ryood/I2S_FG/P1100434.jpg

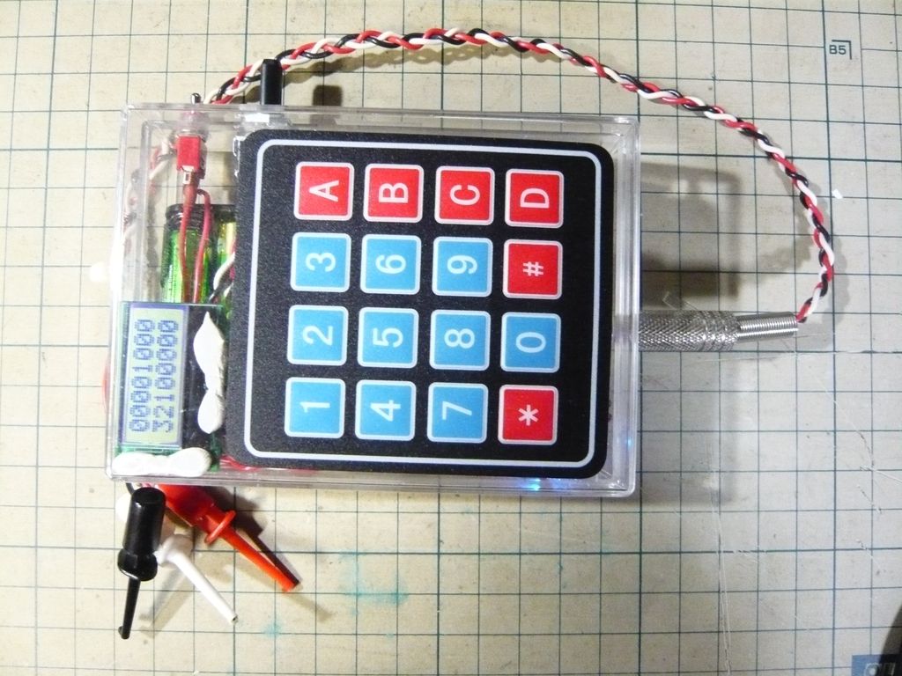
P1100434.jpg
