ryood/I2S_FG/P1100431.jpg

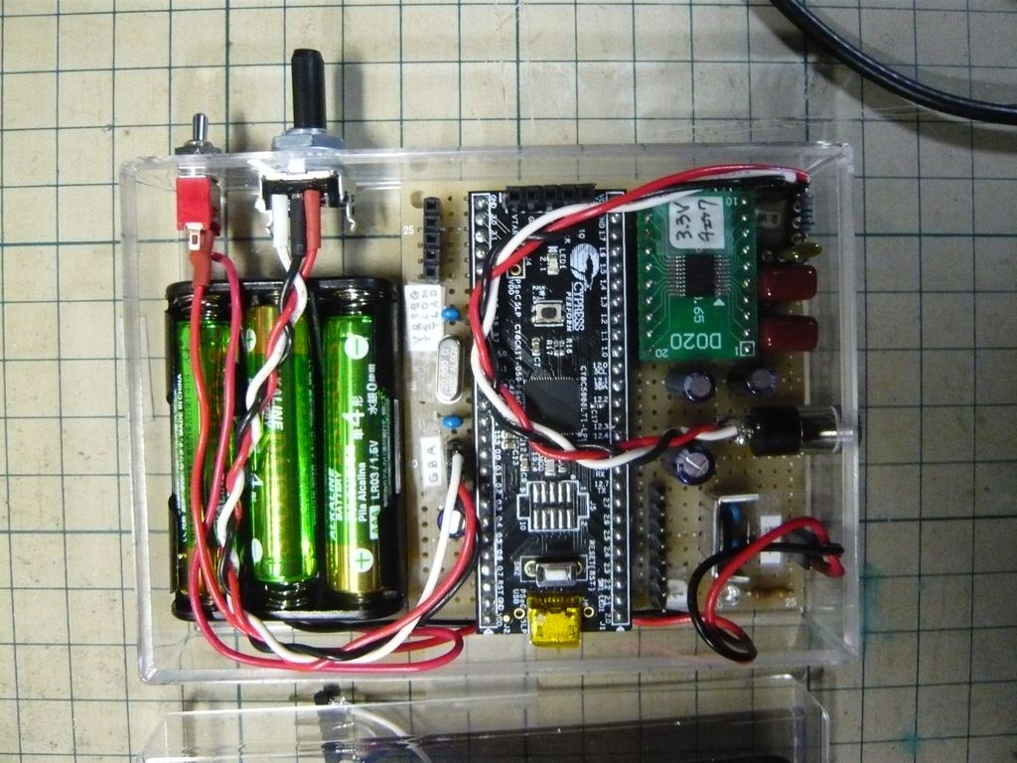
P1100431.jpg
