ryood/I2S_FG/Fritzing/I2S_FG_UI_ブレッドボード.png

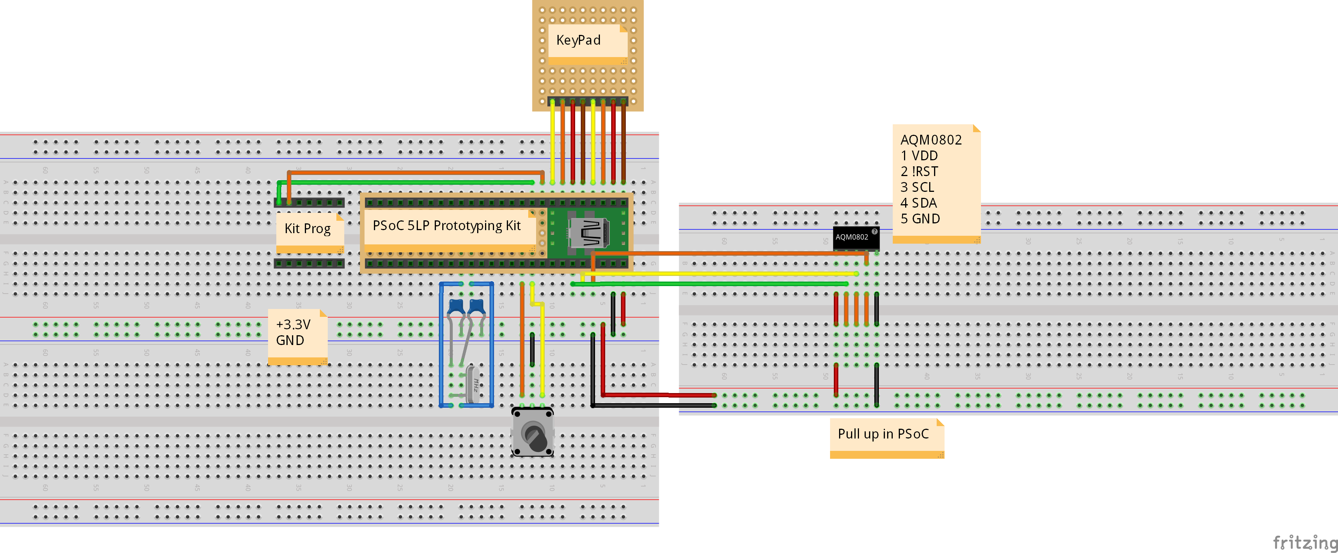
Fritzing/I2S_FG_UI_ブレッドボード.png
