ryood/I2S_FG/Fritzing/PCM5102A-PSoC 5LP Prototyping Kit_ブレッドボード.png

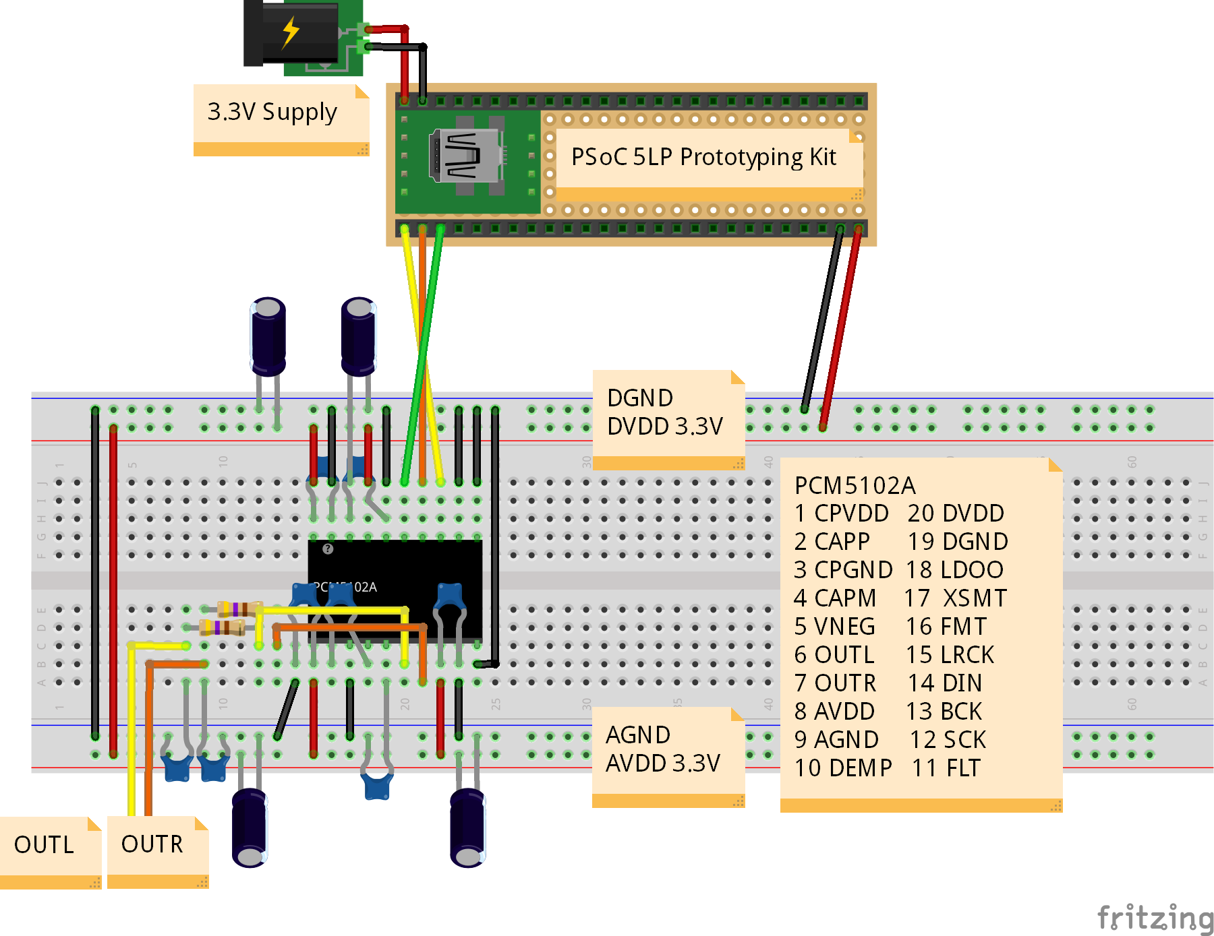
Fritzing/PCM5102A-PSoC 5LP Prototyping Kit_ブレッドボード.png
