ryood/I2S_FG/PCM5102a_FG_brd.png

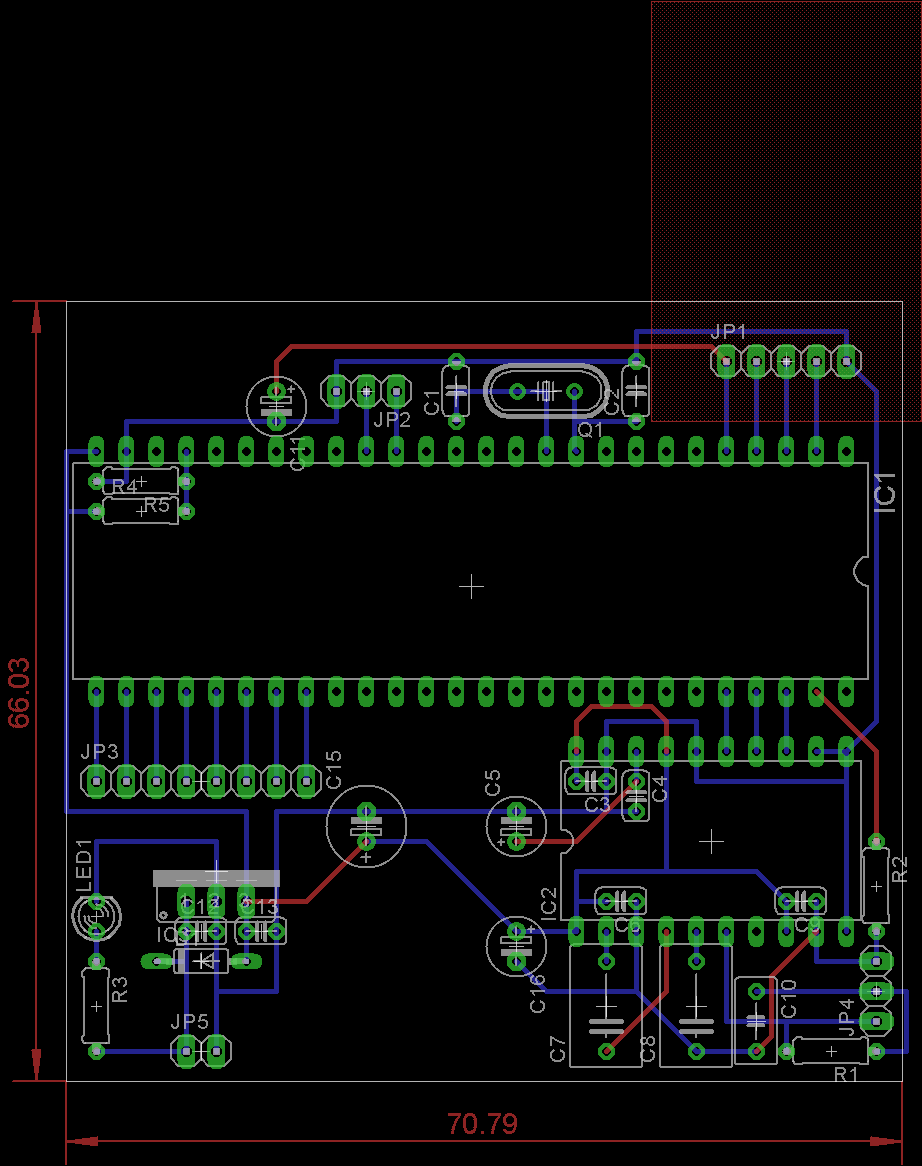
PCM5102a_FG_brd.png
