ryood/I2S_FG/PCM5102a_FG_sch.png

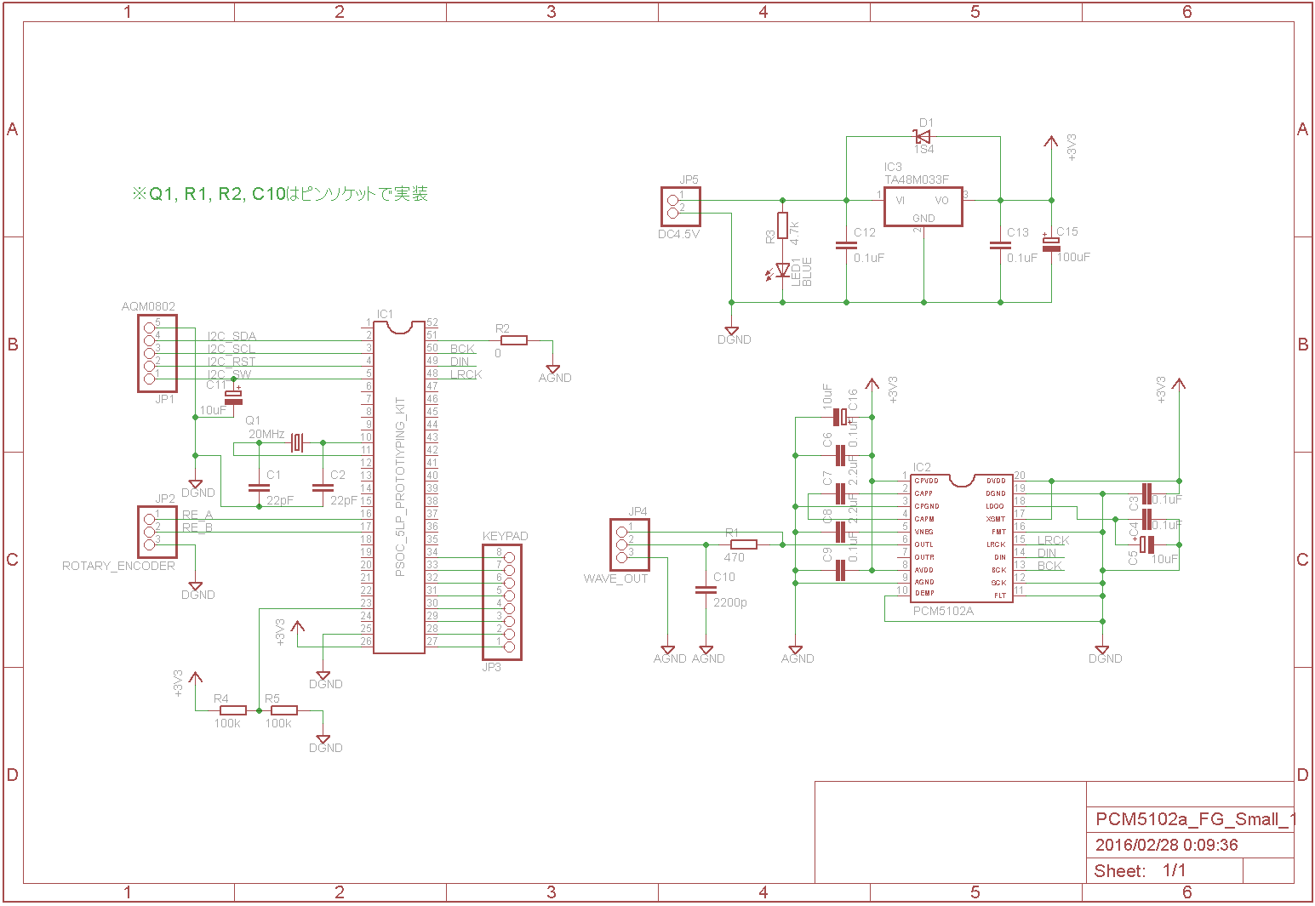
PCM5102a_FG_sch.png
