ryood/I2S_FG/PCM5102a_FG_ケース内配線_ブレッドボード.png

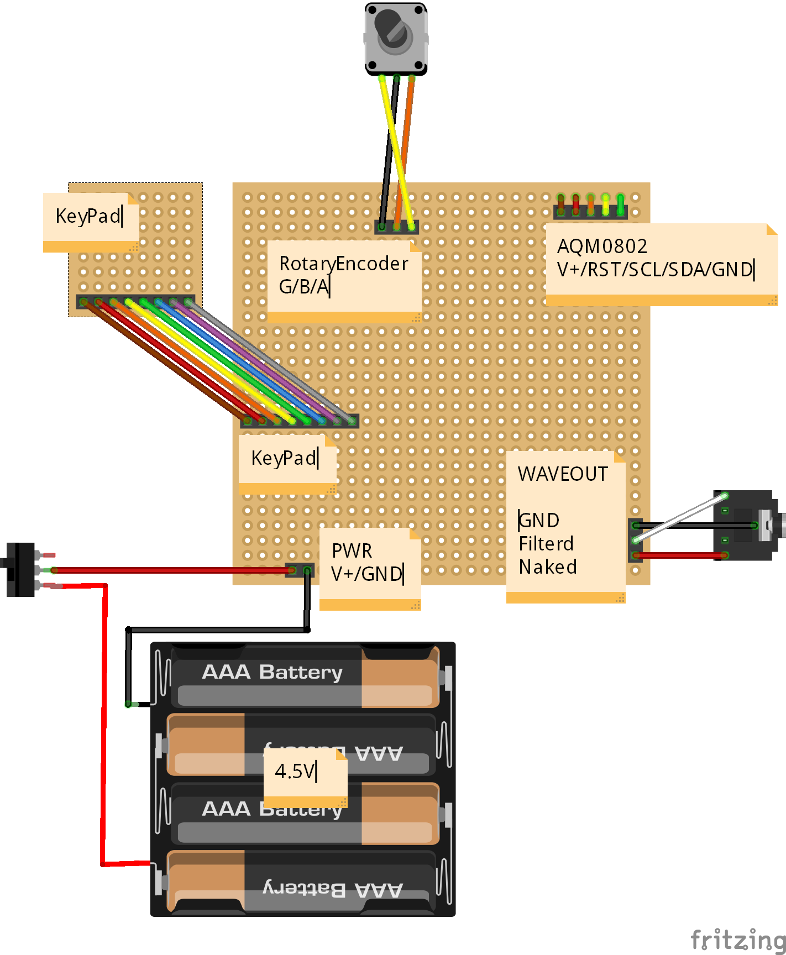
PCM5102a_FG_ケース内配線_ブレッドボード.png
