ryood/I2S_FG/PSoC/I2S Function Generator LCD表示.png

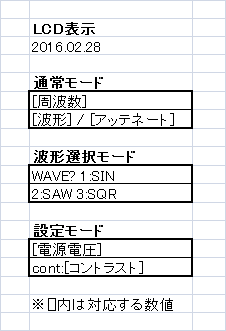
PSoC/I2S Function Generator LCD表示.png
