ryood/I2S_FG/PSoC/I2S Function Generator UI状態遷移図.png

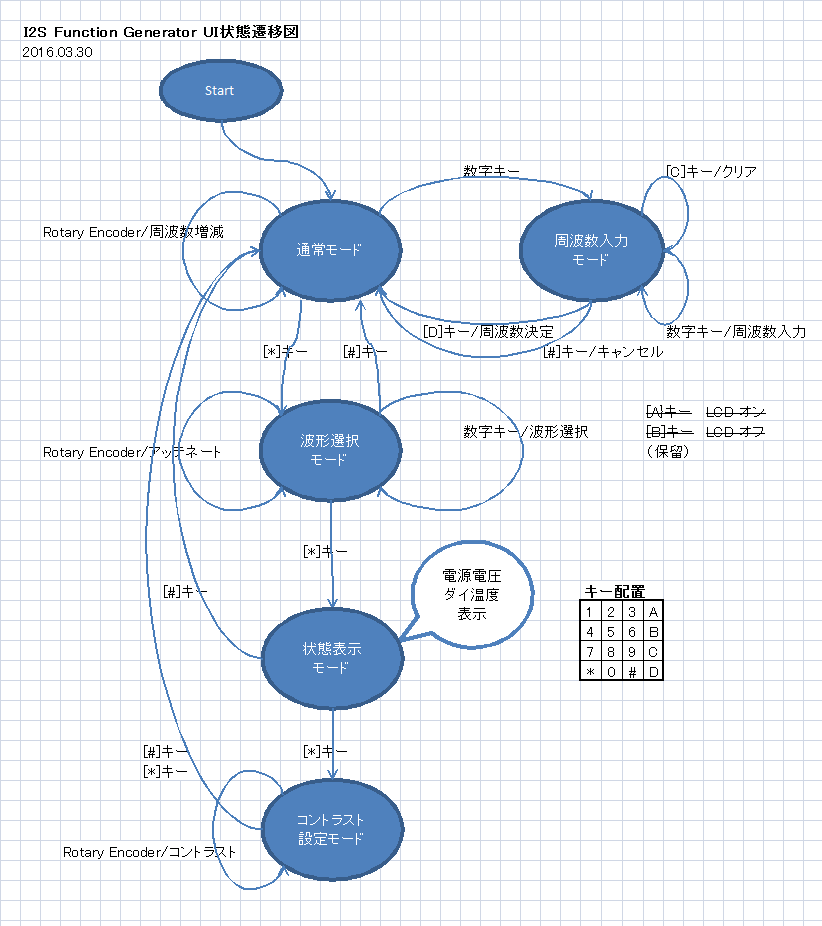
PSoC/I2S Function Generator UI状態遷移図.png
