ryood/I2S_FG/PSoC/I2S_FG_TopDesign_main.png

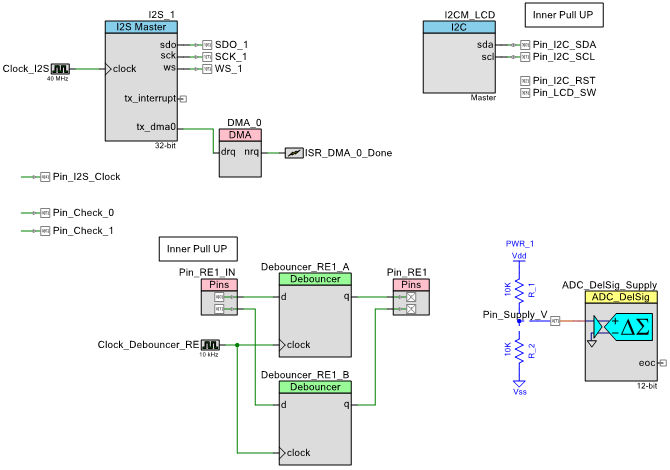
PSoC/I2S_FG_TopDesign_main.png
