ryood/I2S_FG/(list of files, cad)

Other CAD files:
Case/I2S_FG_Case_pb-2.dwg
