ryood/I2S_FG/PSoC/I2S_FG/EEPROM_Test.cydsn/EEPROM_Test_timing.html

# Static Timing Analysis

Project : | EEPROM_Test
Build Time : | 07/14/16 20:55:28
Device : | CY8C5888LTI-LP097
Temperature : | -40C - 85/125C
VDDA : | 5.00
VDDABUF : | 5.00
VDDD : | 5.00
VDDIO0 : | 5.00
VDDIO1 : | 5.00
VDDIO2 : | 5.00
VDDIO3 : | 5.00
VUSB : | 5.00
Voltage : | 5.0

Expand All | Collapse All | Show All Paths | Hide All Paths

+ Timing Violation Section

No Timing Violations

+ Clock Summary Section

Clock | Domain | Nominal Frequency | Required Frequency | Maximum Frequency | Violation
CyILO | CyILO | 1.000 kHz | 1.000 kHz | N/A
CyIMO | CyIMO | 3.000 MHz | 3.000 MHz | N/A
CyMASTER_CLK | CyMASTER_CLK | 24.000 MHz | 24.000 MHz | N/A
CyBUS_CLK | CyMASTER_CLK | 24.000 MHz | 24.000 MHz | 60.872 MHz
UART_IntClock | CyMASTER_CLK | 76.677 kHz | 76.677 kHz | 60.872 MHz
CyPLL_OUT | CyPLL_OUT | 24.000 MHz | 24.000 MHz | N/A

+ Register to Register Section

+ Setup Subsection

+ Source Clock : CyBUS_CLK : Positive edge(Required Frequency 24 MHz)

+ Destination Clock : UART_IntClock : Positive edge(Required Frequency 76.6773 kHz)

Path Delay Requirement : 41.6667ns(24 MHz)

Affects clock : CyMASTER_CLK

Source | Destination | FMax | Delay (ns) | Slack (ns) | Violation
Rx_1(0)/fb | \UART:BUART:sRX:RxShifter:u0\/route_si | 60.872 MHz | 16.428 | 25.239

Type | Location | Fanout | Instance/Net | Source | Dest | Delay (ns)
iocell1 | P12[6] | 1 | Rx_1(0) | Rx_1(0)/in_clock | Rx_1(0)/fb | 2.009
Route | | 1 | Net_7 | Rx_1(0)/fb | \UART:BUART:rx_postpoll\/main_1 | 5.371
macrocell6 | U(0,0) | 1 | \UART:BUART:rx_postpoll\ | \UART:BUART:rx_postpoll\/main_1 | \UART:BUART:rx_postpoll\/q | 3.350
Route | | 1 | \UART:BUART:rx_postpoll\ | \UART:BUART:rx_postpoll\/q | \UART:BUART:sRX:RxShifter:u0\/route_si | 2.228
datapathcell3 | U(0,0) | 1 | \UART:BUART:sRX:RxShifter:u0\ | | SETUP | 3.470
Clock | | | | | Skew | 0.000
Rx_1(0)/fb | \UART:BUART:pollcount_1\/main_3 | 85.918 MHz | 11.639 | 30.028

Type | Location | Fanout | Instance/Net | Source | Dest | Delay (ns)
iocell1 | P12[6] | 1 | Rx_1(0) | Rx_1(0)/in_clock | Rx_1(0)/fb | 2.009
Route | | 1 | Net_7 | Rx_1(0)/fb | \UART:BUART:pollcount_1\/main_3 | 6.120
macrocell21 | U(0,1) | 1 | \UART:BUART:pollcount_1\ | | SETUP | 3.510
Clock | | | | | Skew | 0.000
Rx_1(0)/fb | \UART:BUART:pollcount_0\/main_2 | 85.918 MHz | 11.639 | 30.028

Type | Location | Fanout | Instance/Net | Source | Dest | Delay (ns)
iocell1 | P12[6] | 1 | Rx_1(0) | Rx_1(0)/in_clock | Rx_1(0)/fb | 2.009
Route | | 1 | Net_7 | Rx_1(0)/fb | \UART:BUART:pollcount_0\/main_2 | 6.120
macrocell22 | U(0,1) | 1 | \UART:BUART:pollcount_0\ | | SETUP | 3.510
Clock | | | | | Skew | 0.000
Rx_1(0)/fb | \UART:BUART:rx_last\/main_0 | 85.918 MHz | 11.639 | 30.028

Type | Location | Fanout | Instance/Net | Source | Dest | Delay (ns)
iocell1 | P12[6] | 1 | Rx_1(0) | Rx_1(0)/in_clock | Rx_1(0)/fb | 2.009
Route | | 1 | Net_7 | Rx_1(0)/fb | \UART:BUART:rx_last\/main_0 | 6.120
macrocell24 | U(0,1) | 1 | \UART:BUART:rx_last\ | | SETUP | 3.510
Clock | | | | | Skew | 0.000
Rx_1(0)/fb | \UART:BUART:rx_state_0\/main_9 | 91.827 MHz | 10.890 | 30.777

Type | Location | Fanout | Instance/Net | Source | Dest | Delay (ns)
iocell1 | P12[6] | 1 | Rx_1(0) | Rx_1(0)/in_clock | Rx_1(0)/fb | 2.009
Route | | 1 | Net_7 | Rx_1(0)/fb | \UART:BUART:rx_state_0\/main_9 | 5.371
macrocell15 | U(0,0) | 1 | \UART:BUART:rx_state_0\ | | SETUP | 3.510
Clock | | | | | Skew | 0.000
Rx_1(0)/fb | \UART:BUART:rx_state_2\/main_8 | 94.823 MHz | 10.546 | 31.121

Type | Location | Fanout | Instance/Net | Source | Dest | Delay (ns)
iocell1 | P12[6] | 1 | Rx_1(0) | Rx_1(0)/in_clock | Rx_1(0)/fb | 2.009
Route | | 1 | Net_7 | Rx_1(0)/fb | \UART:BUART:rx_state_2\/main_8 | 5.027
macrocell18 | U(0,0) | 1 | \UART:BUART:rx_state_2\ | | SETUP | 3.510
Clock | | | | | Skew | 0.000
Rx_1(0)/fb | \UART:BUART:rx_status_3\/main_6 | 94.823 MHz | 10.546 | 31.121

Type | Location | Fanout | Instance/Net | Source | Dest | Delay (ns)
iocell1 | P12[6] | 1 | Rx_1(0) | Rx_1(0)/in_clock | Rx_1(0)/fb | 2.009
Route | | 1 | Net_7 | Rx_1(0)/fb | \UART:BUART:rx_status_3\/main_6 | 5.027
macrocell23 | U(0,0) | 1 | \UART:BUART:rx_status_3\ | | SETUP | 3.510
Clock | | | | | Skew | 0.000

+ Source Clock : UART_IntClock : Positive edge(Required Frequency 76.6773 kHz)

+ Destination Clock : UART_IntClock : Positive edge(Required Frequency 76.6773 kHz)

Path Delay Requirement : 13041.7ns(76.6773 kHz)

Source | Destination | FMax | Delay (ns) | Slack (ns) | Violation
\UART:BUART:tx_state_2\/q | \UART:BUART:sTX:sCLOCK:TxBitClkGen\/cs_addr_0 | 61.076 MHz | 16.373 | 13025.294

Type | Location | Fanout | Instance/Net | Source | Dest | Delay (ns)
macrocell12 | U(0,1) | 1 | \UART:BUART:tx_state_2\ | \UART:BUART:tx_state_2\/clock_0 | \UART:BUART:tx_state_2\/q | 1.250
Route | | 1 | \UART:BUART:tx_state_2\ | \UART:BUART:tx_state_2\/q | \UART:BUART:counter_load_not\/main_3 | 3.281
macrocell2 | U(0,1) | 1 | \UART:BUART:counter_load_not\ | \UART:BUART:counter_load_not\/main_3 | \UART:BUART:counter_load_not\/q | 3.350
Route | | 1 | \UART:BUART:counter_load_not\ | \UART:BUART:counter_load_not\/q | \UART:BUART:sTX:sCLOCK:TxBitClkGen\/cs_addr_0 | 2.302
datapathcell2 | U(0,1) | 1 | \UART:BUART:sTX:sCLOCK:TxBitClkGen\ | | SETUP | 6.190
Clock | | | | | Skew | 0.000
\UART:BUART:tx_state_1\/q | \UART:BUART:sTX:sCLOCK:TxBitClkGen\/cs_addr_0 | 61.237 MHz | 16.330 | 13025.337

Type | Location | Fanout | Instance/Net | Source | Dest | Delay (ns)
macrocell10 | U(0,1) | 1 | \UART:BUART:tx_state_1\ | \UART:BUART:tx_state_1\/clock_0 | \UART:BUART:tx_state_1\/q | 1.250
Route | | 1 | \UART:BUART:tx_state_1\ | \UART:BUART:tx_state_1\/q | \UART:BUART:counter_load_not\/main_0 | 3.238
macrocell2 | U(0,1) | 1 | \UART:BUART:counter_load_not\ | \UART:BUART:counter_load_not\/main_0 | \UART:BUART:counter_load_not\/q | 3.350
Route | | 1 | \UART:BUART:counter_load_not\ | \UART:BUART:counter_load_not\/q | \UART:BUART:sTX:sCLOCK:TxBitClkGen\/cs_addr_0 | 2.302
datapathcell2 | U(0,1) | 1 | \UART:BUART:sTX:sCLOCK:TxBitClkGen\ | | SETUP | 6.190
Clock | | | | | Skew | 0.000
\UART:BUART:tx_state_0\/q | \UART:BUART:sTX:sCLOCK:TxBitClkGen\/cs_addr_0 | 61.474 MHz | 16.267 | 13025.400

Type | Location | Fanout | Instance/Net | Source | Dest | Delay (ns)
macrocell11 | U(1,1) | 1 | \UART:BUART:tx_state_0\ | \UART:BUART:tx_state_0\/clock_0 | \UART:BUART:tx_state_0\/q | 1.250
Route | | 1 | \UART:BUART:tx_state_0\ | \UART:BUART:tx_state_0\/q | \UART:BUART:counter_load_not\/main_1 | 3.175
macrocell2 | U(0,1) | 1 | \UART:BUART:counter_load_not\ | \UART:BUART:counter_load_not\/main_1 | \UART:BUART:counter_load_not\/q | 3.350
Route | | 1 | \UART:BUART:counter_load_not\ | \UART:BUART:counter_load_not\/q | \UART:BUART:sTX:sCLOCK:TxBitClkGen\/cs_addr_0 | 2.302
datapathcell2 | U(0,1) | 1 | \UART:BUART:sTX:sCLOCK:TxBitClkGen\ | | SETUP | 6.190
Clock | | | | | Skew | 0.000
\UART:BUART:sTX:sCLOCK:TxBitClkGen\/ce0_reg | \UART:BUART:sTX:sCLOCK:TxBitClkGen\/cs_addr_0 | 64.354 MHz | 15.539 | 13026.128

Type | Location | Fanout | Instance/Net | Source | Dest | Delay (ns)
datapathcell2 | U(0,1) | 1 | \UART:BUART:sTX:sCLOCK:TxBitClkGen\ | \UART:BUART:sTX:sCLOCK:TxBitClkGen\/clock | \UART:BUART:sTX:sCLOCK:TxBitClkGen\/ce0_reg | 0.190
Route | | 1 | \UART:BUART:tx_bitclk_enable_pre\ | \UART:BUART:sTX:sCLOCK:TxBitClkGen\/ce0_reg | \UART:BUART:counter_load_not\/main_2 | 3.507
macrocell2 | U(0,1) | 1 | \UART:BUART:counter_load_not\ | \UART:BUART:counter_load_not\/main_2 | \UART:BUART:counter_load_not\/q | 3.350
Route | | 1 | \UART:BUART:counter_load_not\ | \UART:BUART:counter_load_not\/q | \UART:BUART:sTX:sCLOCK:TxBitClkGen\/cs_addr_0 | 2.302
datapathcell2 | U(0,1) | 1 | \UART:BUART:sTX:sCLOCK:TxBitClkGen\ | | SETUP | 6.190
Clock | | | | | Skew | 0.000
\UART:BUART:rx_state_0\/q | \UART:BUART:sRX:RxBitCounter\/load | 64.533 MHz | 15.496 | 13026.171

Type | Location | Fanout | Instance/Net | Source | Dest | Delay (ns)
macrocell15 | U(0,0) | 1 | \UART:BUART:rx_state_0\ | \UART:BUART:rx_state_0\/clock_0 | \UART:BUART:rx_state_0\/q | 1.250
Route | | 1 | \UART:BUART:rx_state_0\ | \UART:BUART:rx_state_0\/q | \UART:BUART:rx_counter_load\/main_1 | 3.287
macrocell5 | U(0,0) | 1 | \UART:BUART:rx_counter_load\ | \UART:BUART:rx_counter_load\/main_1 | \UART:BUART:rx_counter_load\/q | 3.350
Route | | 1 | \UART:BUART:rx_counter_load\ | \UART:BUART:rx_counter_load\/q | \UART:BUART:sRX:RxBitCounter\/load | 2.249
count7cell | U(0,0) | 1 | \UART:BUART:sRX:RxBitCounter\ | | SETUP | 5.360
Clock | | | | | Skew | 0.000
\UART:BUART:rx_state_3\/q | \UART:BUART:sRX:RxBitCounter\/load | 65.011 MHz | 15.382 | 13026.285

Type | Location | Fanout | Instance/Net | Source | Dest | Delay (ns)
macrocell17 | U(0,0) | 1 | \UART:BUART:rx_state_3\ | \UART:BUART:rx_state_3\/clock_0 | \UART:BUART:rx_state_3\/q | 1.250
Route | | 1 | \UART:BUART:rx_state_3\ | \UART:BUART:rx_state_3\/q | \UART:BUART:rx_counter_load\/main_2 | 3.173
macrocell5 | U(0,0) | 1 | \UART:BUART:rx_counter_load\ | \UART:BUART:rx_counter_load\/main_2 | \UART:BUART:rx_counter_load\/q | 3.350
Route | | 1 | \UART:BUART:rx_counter_load\ | \UART:BUART:rx_counter_load\/q | \UART:BUART:sRX:RxBitCounter\/load | 2.249
count7cell | U(0,0) | 1 | \UART:BUART:sRX:RxBitCounter\ | | SETUP | 5.360
Clock | | | | | Skew | 0.000
\UART:BUART:tx_ctrl_mark_last\/q | \UART:BUART:sRX:RxBitCounter\/load | 65.274 MHz | 15.320 | 13026.347

Type | Location | Fanout | Instance/Net | Source | Dest | Delay (ns)
macrocell14 | U(1,0) | 1 | \UART:BUART:tx_ctrl_mark_last\ | \UART:BUART:tx_ctrl_mark_last\/clock_0 | \UART:BUART:tx_ctrl_mark_last\/q | 1.250
Route | | 1 | \UART:BUART:tx_ctrl_mark_last\ | \UART:BUART:tx_ctrl_mark_last\/q | \UART:BUART:rx_counter_load\/main_0 | 3.111
macrocell5 | U(0,0) | 1 | \UART:BUART:rx_counter_load\ | \UART:BUART:rx_counter_load\/main_0 | \UART:BUART:rx_counter_load\/q | 3.350
Route | | 1 | \UART:BUART:rx_counter_load\ | \UART:BUART:rx_counter_load\/q | \UART:BUART:sRX:RxBitCounter\/load | 2.249
count7cell | U(0,0) | 1 | \UART:BUART:sRX:RxBitCounter\ | | SETUP | 5.360
Clock | | | | | Skew | 0.000
\UART:BUART:rx_state_2\/q | \UART:BUART:sRX:RxBitCounter\/load | 65.828 MHz | 15.191 | 13026.476

Type | Location | Fanout | Instance/Net | Source | Dest | Delay (ns)
macrocell18 | U(0,0) | 1 | \UART:BUART:rx_state_2\ | \UART:BUART:rx_state_2\/clock_0 | \UART:BUART:rx_state_2\/q | 1.250
Route | | 1 | \UART:BUART:rx_state_2\ | \UART:BUART:rx_state_2\/q | \UART:BUART:rx_counter_load\/main_3 | 2.982
macrocell5 | U(0,0) | 1 | \UART:BUART:rx_counter_load\ | \UART:BUART:rx_counter_load\/main_3 | \UART:BUART:rx_counter_load\/q | 3.350
Route | | 1 | \UART:BUART:rx_counter_load\ | \UART:BUART:rx_counter_load\/q | \UART:BUART:sRX:RxBitCounter\/load | 2.249
count7cell | U(0,0) | 1 | \UART:BUART:sRX:RxBitCounter\ | | SETUP | 5.360
Clock | | | | | Skew | 0.000
\UART:BUART:pollcount_0\/q | \UART:BUART:sRX:RxShifter:u0\/route_si | 68.747 MHz | 14.546 | 13027.121

Type | Location | Fanout | Instance/Net | Source | Dest | Delay (ns)
macrocell22 | U(0,1) | 1 | \UART:BUART:pollcount_0\ | \UART:BUART:pollcount_0\/clock_0 | \UART:BUART:pollcount_0\/q | 1.250
Route | | 1 | \UART:BUART:pollcount_0\ | \UART:BUART:pollcount_0\/q | \UART:BUART:rx_postpoll\/main_2 | 4.248
macrocell6 | U(0,0) | 1 | \UART:BUART:rx_postpoll\ | \UART:BUART:rx_postpoll\/main_2 | \UART:BUART:rx_postpoll\/q | 3.350
Route | | 1 | \UART:BUART:rx_postpoll\ | \UART:BUART:rx_postpoll\/q | \UART:BUART:sRX:RxShifter:u0\/route_si | 2.228
datapathcell3 | U(0,0) | 1 | \UART:BUART:sRX:RxShifter:u0\ | | SETUP | 3.470
Clock | | | | | Skew | 0.000
\UART:BUART:pollcount_1\/q | \UART:BUART:sRX:RxShifter:u0\/route_si | 69.391 MHz | 14.411 | 13027.256

Type | Location | Fanout | Instance/Net | Source | Dest | Delay (ns)
macrocell21 | U(0,1) | 1 | \UART:BUART:pollcount_1\ | \UART:BUART:pollcount_1\/clock_0 | \UART:BUART:pollcount_1\/q | 1.250
Route | | 1 | \UART:BUART:pollcount_1\ | \UART:BUART:pollcount_1\/q | \UART:BUART:rx_postpoll\/main_0 | 4.113
macrocell6 | U(0,0) | 1 | \UART:BUART:rx_postpoll\ | \UART:BUART:rx_postpoll\/main_0 | \UART:BUART:rx_postpoll\/q | 3.350
Route | | 1 | \UART:BUART:rx_postpoll\ | \UART:BUART:rx_postpoll\/q | \UART:BUART:sRX:RxShifter:u0\/route_si | 2.228
datapathcell3 | U(0,0) | 1 | \UART:BUART:sRX:RxShifter:u0\ | | SETUP | 3.470
Clock | | | | | Skew | 0.000

+ Hold Subsection

+ Source Clock : CyBUS_CLK : Positive edge

+ Destination Clock : UART_IntClock : Positive edge

Source | Destination | Slack (ns) | Violation
Rx_1(0)/fb | \UART:BUART:rx_state_2\/main_8 | 7.036

Type | Location | Fanout | Instance/Net | Source | Dest | Delay (ns)
iocell1 | P12[6] | 1 | Rx_1(0) | Rx_1(0)/in_clock | Rx_1(0)/fb | 2.009
Route | | 1 | Net_7 | Rx_1(0)/fb | \UART:BUART:rx_state_2\/main_8 | 5.027
macrocell18 | U(0,0) | 1 | \UART:BUART:rx_state_2\ | | HOLD | 0.000
Clock | | | | | Skew | 0.000
Rx_1(0)/fb | \UART:BUART:rx_status_3\/main_6 | 7.036

Type | Location | Fanout | Instance/Net | Source | Dest | Delay (ns)
iocell1 | P12[6] | 1 | Rx_1(0) | Rx_1(0)/in_clock | Rx_1(0)/fb | 2.009
Route | | 1 | Net_7 | Rx_1(0)/fb | \UART:BUART:rx_status_3\/main_6 | 5.027
macrocell23 | U(0,0) | 1 | \UART:BUART:rx_status_3\ | | HOLD | 0.000
Clock | | | | | Skew | 0.000
Rx_1(0)/fb | \UART:BUART:rx_state_0\/main_9 | 7.380

Type | Location | Fanout | Instance/Net | Source | Dest | Delay (ns)
iocell1 | P12[6] | 1 | Rx_1(0) | Rx_1(0)/in_clock | Rx_1(0)/fb | 2.009
Route | | 1 | Net_7 | Rx_1(0)/fb | \UART:BUART:rx_state_0\/main_9 | 5.371
macrocell15 | U(0,0) | 1 | \UART:BUART:rx_state_0\ | | HOLD | 0.000
Clock | | | | | Skew | 0.000
Rx_1(0)/fb | \UART:BUART:pollcount_1\/main_3 | 8.129

Type | Location | Fanout | Instance/Net | Source | Dest | Delay (ns)
iocell1 | P12[6] | 1 | Rx_1(0) | Rx_1(0)/in_clock | Rx_1(0)/fb | 2.009
Route | | 1 | Net_7 | Rx_1(0)/fb | \UART:BUART:pollcount_1\/main_3 | 6.120
macrocell21 | U(0,1) | 1 | \UART:BUART:pollcount_1\ | | HOLD | 0.000
Clock | | | | | Skew | 0.000
Rx_1(0)/fb | \UART:BUART:pollcount_0\/main_2 | 8.129

Type | Location | Fanout | Instance/Net | Source | Dest | Delay (ns)
iocell1 | P12[6] | 1 | Rx_1(0) | Rx_1(0)/in_clock | Rx_1(0)/fb | 2.009
Route | | 1 | Net_7 | Rx_1(0)/fb | \UART:BUART:pollcount_0\/main_2 | 6.120
macrocell22 | U(0,1) | 1 | \UART:BUART:pollcount_0\ | | HOLD | 0.000
Clock | | | | | Skew | 0.000
Rx_1(0)/fb | \UART:BUART:rx_last\/main_0 | 8.129

Type | Location | Fanout | Instance/Net | Source | Dest | Delay (ns)
iocell1 | P12[6] | 1 | Rx_1(0) | Rx_1(0)/in_clock | Rx_1(0)/fb | 2.009
Route | | 1 | Net_7 | Rx_1(0)/fb | \UART:BUART:rx_last\/main_0 | 6.120
macrocell24 | U(0,1) | 1 | \UART:BUART:rx_last\ | | HOLD | 0.000
Clock | | | | | Skew | 0.000
Rx_1(0)/fb | \UART:BUART:sRX:RxShifter:u0\/route_si | 12.958

Type | Location | Fanout | Instance/Net | Source | Dest | Delay (ns)
iocell1 | P12[6] | 1 | Rx_1(0) | Rx_1(0)/in_clock | Rx_1(0)/fb | 2.009
Route | | 1 | Net_7 | Rx_1(0)/fb | \UART:BUART:rx_postpoll\/main_1 | 5.371
macrocell6 | U(0,0) | 1 | \UART:BUART:rx_postpoll\ | \UART:BUART:rx_postpoll\/main_1 | \UART:BUART:rx_postpoll\/q | 3.350
Route | | 1 | \UART:BUART:rx_postpoll\ | \UART:BUART:rx_postpoll\/q | \UART:BUART:sRX:RxShifter:u0\/route_si | 2.228
datapathcell3 | U(0,0) | 1 | \UART:BUART:sRX:RxShifter:u0\ | | HOLD | 0.000
Clock | | | | | Skew | 0.000

+ Source Clock : UART_IntClock : Positive edge

+ Destination Clock : UART_IntClock : Positive edge

Source | Destination | Slack (ns) | Violation
\UART:BUART:rx_status_3\/q | \UART:BUART:sRX:RxSts\/status_3 | 2.118

Type | Location | Fanout | Instance/Net | Source | Dest | Delay (ns)
macrocell23 | U(0,0) | 1 | \UART:BUART:rx_status_3\ | \UART:BUART:rx_status_3\/clock_0 | \UART:BUART:rx_status_3\/q | 1.250
Route | | 1 | \UART:BUART:rx_status_3\ | \UART:BUART:rx_status_3\/q | \UART:BUART:sRX:RxSts\/status_3 | 2.868
statusicell2 | U(0,1) | 1 | \UART:BUART:sRX:RxSts\ | | HOLD | -2.000
Clock | | | | | Skew | 0.000
\UART:BUART:sTX:sCLOCK:TxBitClkGen\/ce1_reg | \UART:BUART:tx_state_1\/main_4 | 2.972

Type | Location | Fanout | Instance/Net | Source | Dest | Delay (ns)
datapathcell2 | U(0,1) | 1 | \UART:BUART:sTX:sCLOCK:TxBitClkGen\ | \UART:BUART:sTX:sCLOCK:TxBitClkGen\/clock | \UART:BUART:sTX:sCLOCK:TxBitClkGen\/ce1_reg | 0.190
Route | | 1 | \UART:BUART:tx_counter_dp\ | \UART:BUART:sTX:sCLOCK:TxBitClkGen\/ce1_reg | \UART:BUART:tx_state_1\/main_4 | 2.782
macrocell10 | U(0,1) | 1 | \UART:BUART:tx_state_1\ | | HOLD | 0.000
Clock | | | | | Skew | 0.000
\UART:BUART:sTX:sCLOCK:TxBitClkGen\/ce1_reg | \UART:BUART:tx_state_2\/main_4 | 2.972

Type | Location | Fanout | Instance/Net | Source | Dest | Delay (ns)
datapathcell2 | U(0,1) | 1 | \UART:BUART:sTX:sCLOCK:TxBitClkGen\ | \UART:BUART:sTX:sCLOCK:TxBitClkGen\/clock | \UART:BUART:sTX:sCLOCK:TxBitClkGen\/ce1_reg | 0.190
Route | | 1 | \UART:BUART:tx_counter_dp\ | \UART:BUART:sTX:sCLOCK:TxBitClkGen\/ce1_reg | \UART:BUART:tx_state_2\/main_4 | 2.782
macrocell12 | U(0,1) | 1 | \UART:BUART:tx_state_2\ | | HOLD | 0.000
Clock | | | | | Skew | 0.000
\UART:BUART:sTX:sCLOCK:TxBitClkGen\/ce1_reg | \UART:BUART:txn\/main_5 | 2.988

Type | Location | Fanout | Instance/Net | Source | Dest | Delay (ns)
datapathcell2 | U(0,1) | 1 | \UART:BUART:sTX:sCLOCK:TxBitClkGen\ | \UART:BUART:sTX:sCLOCK:TxBitClkGen\/clock | \UART:BUART:sTX:sCLOCK:TxBitClkGen\/ce1_reg | 0.190
Route | | 1 | \UART:BUART:tx_counter_dp\ | \UART:BUART:sTX:sCLOCK:TxBitClkGen\/ce1_reg | \UART:BUART:txn\/main_5 | 2.798
macrocell9 | U(1,1) | 1 | \UART:BUART:txn\ | | HOLD | 0.000
Clock | | | | | Skew | 0.000
\UART:BUART:sRX:RxBitCounter\/count_6 | \UART:BUART:rx_load_fifo\/main_5 | 3.196

Type | Location | Fanout | Instance/Net | Source | Dest | Delay (ns)
count7cell | U(0,0) | 1 | \UART:BUART:sRX:RxBitCounter\ | \UART:BUART:sRX:RxBitCounter\/clock | \UART:BUART:sRX:RxBitCounter\/count_6 | 0.620
Route | | 1 | \UART:BUART:rx_count_6\ | \UART:BUART:sRX:RxBitCounter\/count_6 | \UART:BUART:rx_load_fifo\/main_5 | 2.576
macrocell16 | U(0,0) | 1 | \UART:BUART:rx_load_fifo\ | | HOLD | 0.000
Clock | | | | | Skew | 0.000
\UART:BUART:sRX:RxBitCounter\/count_6 | \UART:BUART:rx_state_2\/main_5 | 3.196

Type | Location | Fanout | Instance/Net | Source | Dest | Delay (ns)
count7cell | U(0,0) | 1 | \UART:BUART:sRX:RxBitCounter\ | \UART:BUART:sRX:RxBitCounter\/clock | \UART:BUART:sRX:RxBitCounter\/count_6 | 0.620
Route | | 1 | \UART:BUART:rx_count_6\ | \UART:BUART:sRX:RxBitCounter\/count_6 | \UART:BUART:rx_state_2\/main_5 | 2.576
macrocell18 | U(0,0) | 1 | \UART:BUART:rx_state_2\ | | HOLD | 0.000
Clock | | | | | Skew | 0.000
\UART:BUART:sRX:RxBitCounter\/count_6 | \UART:BUART:rx_state_0\/main_5 | 3.205

Type | Location | Fanout | Instance/Net | Source | Dest | Delay (ns)
count7cell | U(0,0) | 1 | \UART:BUART:sRX:RxBitCounter\ | \UART:BUART:sRX:RxBitCounter\/clock | \UART:BUART:sRX:RxBitCounter\/count_6 | 0.620
Route | | 1 | \UART:BUART:rx_count_6\ | \UART:BUART:sRX:RxBitCounter\/count_6 | \UART:BUART:rx_state_0\/main_5 | 2.585
macrocell15 | U(0,0) | 1 | \UART:BUART:rx_state_0\ | | HOLD | 0.000
Clock | | | | | Skew | 0.000
\UART:BUART:sRX:RxBitCounter\/count_6 | \UART:BUART:rx_state_3\/main_5 | 3.205

Type | Location | Fanout | Instance/Net | Source | Dest | Delay (ns)
count7cell | U(0,0) | 1 | \UART:BUART:sRX:RxBitCounter\ | \UART:BUART:sRX:RxBitCounter\/clock | \UART:BUART:sRX:RxBitCounter\/count_6 | 0.620
Route | | 1 | \UART:BUART:rx_count_6\ | \UART:BUART:sRX:RxBitCounter\/count_6 | \UART:BUART:rx_state_3\/main_5 | 2.585
macrocell17 | U(0,0) | 1 | \UART:BUART:rx_state_3\ | | HOLD | 0.000
Clock | | | | | Skew | 0.000
\UART:BUART:sRX:RxBitCounter\/count_4 | \UART:BUART:rx_load_fifo\/main_7 | 3.333

Type | Location | Fanout | Instance/Net | Source | Dest | Delay (ns)
count7cell | U(0,0) | 1 | \UART:BUART:sRX:RxBitCounter\ | \UART:BUART:sRX:RxBitCounter\/clock | \UART:BUART:sRX:RxBitCounter\/count_4 | 0.620
Route | | 1 | \UART:BUART:rx_count_4\ | \UART:BUART:sRX:RxBitCounter\/count_4 | \UART:BUART:rx_load_fifo\/main_7 | 2.713
macrocell16 | U(0,0) | 1 | \UART:BUART:rx_load_fifo\ | | HOLD | 0.000
Clock | | | | | Skew | 0.000
\UART:BUART:sRX:RxBitCounter\/count_4 | \UART:BUART:rx_state_2\/main_7 | 3.333

Type | Location | Fanout | Instance/Net | Source | Dest | Delay (ns)
count7cell | U(0,0) | 1 | \UART:BUART:sRX:RxBitCounter\ | \UART:BUART:sRX:RxBitCounter\/clock | \UART:BUART:sRX:RxBitCounter\/count_4 | 0.620
Route | | 1 | \UART:BUART:rx_count_4\ | \UART:BUART:sRX:RxBitCounter\/count_4 | \UART:BUART:rx_state_2\/main_7 | 2.713
macrocell18 | U(0,0) | 1 | \UART:BUART:rx_state_2\ | | HOLD | 0.000
Clock | | | | | Skew | 0.000

+ Clock To Output Section

+ UART_IntClock

Source | Destination | Delay (ns)
\UART:BUART:txn\/q | Tx_1(0)_PAD | 29.817

Type | Location | Fanout | Instance/Net | Source | Dest | Delay (ns)
macrocell9 | U(1,1) | 1 | \UART:BUART:txn\ | \UART:BUART:txn\/clock_0 | \UART:BUART:txn\/q | 1.250
Route | | 1 | \UART:BUART:txn\ | \UART:BUART:txn\/q | Net_2/main_0 | 2.873
macrocell1 | U(1,0) | 1 | Net_2 | Net_2/main_0 | Net_2/q | 3.350
Route | | 1 | Net_2 | Net_2/q | Tx_1(0)/pin_input | 5.377
iocell2 | P12[7] | 1 | Tx_1(0) | Tx_1(0)/pin_input | Tx_1(0)/pad_out | 16.967
Route | | 1 | Tx_1(0)_PAD | Tx_1(0)/pad_out | Tx_1(0)_PAD | 0.000
Clock | | | | | Clock path delay | 0.000
