ryood/I2S_FG/PSoC/I2S_FG/UI_Test.cydsn/UI_Test_timing.html

# Static Timing Analysis

Project : | UI_Test
Build Time : | 02/19/16 04:50:36
Device : | CY8C5888LTI-LP097
Temperature : | -40C - 85/125C
VDDA : | 5.00
VDDABUF : | 5.00
VDDD : | 5.00
VDDIO0 : | 5.00
VDDIO1 : | 5.00
VDDIO2 : | 5.00
VDDIO3 : | 5.00
VUSB : | 5.00
Voltage : | 5.0

Expand All | Collapse All | Show All Paths | Hide All Paths

+ Timing Violation Section

No Timing Violations

+ Clock Summary Section

Clock | Domain | Nominal Frequency | Required Frequency | Maximum Frequency | Violation
Clock_I2S(routed) | Clock_I2S(routed) | 48.000 MHz | 48.000 MHz | N/A
CyBUS_CLK(fixed-function) | CyBUS_CLK(fixed-function) | 48.000 MHz | 48.000 MHz | N/A
CyILO | CyILO | 1.000 kHz | 1.000 kHz | N/A
CyIMO | CyIMO | 12.000 MHz | 12.000 MHz | N/A
CyMASTER_CLK | CyMASTER_CLK | 48.000 MHz | 48.000 MHz | N/A
CyBUS_CLK | CyMASTER_CLK | 48.000 MHz | 48.000 MHz | 74.710 MHz
Clock_I2S | CyMASTER_CLK | 48.000 MHz | 48.000 MHz | N/A
UART_IntClock | CyMASTER_CLK | 76.800 kHz | 76.800 kHz | 48.146 MHz
Clock_RE | CyMASTER_CLK | 10.000 kHz | 10.000 kHz | N/A
CyPLL_OUT | CyPLL_OUT | 48.000 MHz | 48.000 MHz | N/A
CyXTAL | CyXTAL | 12.000 MHz | 12.000 MHz | N/A

+ Register to Register Section

+ Setup Subsection

+ Source Clock : CyBUS_CLK : Positive edge(Required Frequency 48 MHz)

+ Destination Clock : UART_IntClock : Positive edge(Required Frequency 76.8 kHz)

Path Delay Requirement : 20.8333ns(48 MHz)

Affects clock : CyMASTER_CLK

Source | Destination | FMax | Delay (ns) | Slack (ns) | Violation
Rx_1(0)_SYNC/out | \UART:BUART:sRX:RxShifter:u0\/route_si | 74.710 MHz | 13.385 | 7.448

Type | Location | Fanout | Instance/Net | Source | Dest | Delay (ns)
synccell | U(2,4) | 1 | Rx_1(0)_SYNC | Rx_1(0)_SYNC/clock | Rx_1(0)_SYNC/out | 1.020
Route | | 1 | Net_7_SYNCOUT | Rx_1(0)_SYNC/out | \UART:BUART:rx_postpoll\/main_2 | 3.256
macrocell6 | U(3,3) | 1 | \UART:BUART:rx_postpoll\ | \UART:BUART:rx_postpoll\/main_2 | \UART:BUART:rx_postpoll\/q | 3.350
Route | | 1 | \UART:BUART:rx_postpoll\ | \UART:BUART:rx_postpoll\/q | \UART:BUART:sRX:RxShifter:u0\/route_si | 2.289
datapathcell3 | U(3,3) | 1 | \UART:BUART:sRX:RxShifter:u0\ | | SETUP | 3.470
Clock | | | | | Skew | 0.000
Rx_1(0)_SYNC/out | \UART:BUART:pollcount_0\/main_3 | 128.436 MHz | 7.786 | 13.047

Type | Location | Fanout | Instance/Net | Source | Dest | Delay (ns)
synccell | U(2,4) | 1 | Rx_1(0)_SYNC | Rx_1(0)_SYNC/clock | Rx_1(0)_SYNC/out | 1.020
Route | | 1 | Net_7_SYNCOUT | Rx_1(0)_SYNC/out | \UART:BUART:pollcount_0\/main_3 | 3.256
macrocell22 | U(3,3) | 1 | \UART:BUART:pollcount_0\ | | SETUP | 3.510
Clock | | | | | Skew | 0.000
Rx_1(0)_SYNC/out | \UART:BUART:rx_last\/main_0 | 128.436 MHz | 7.786 | 13.047

Type | Location | Fanout | Instance/Net | Source | Dest | Delay (ns)
synccell | U(2,4) | 1 | Rx_1(0)_SYNC | Rx_1(0)_SYNC/clock | Rx_1(0)_SYNC/out | 1.020
Route | | 1 | Net_7_SYNCOUT | Rx_1(0)_SYNC/out | \UART:BUART:rx_last\/main_0 | 3.256
macrocell24 | U(3,3) | 1 | \UART:BUART:rx_last\ | | SETUP | 3.510
Clock | | | | | Skew | 0.000
Rx_1(0)_SYNC/out | \UART:BUART:pollcount_1\/main_4 | 128.634 MHz | 7.774 | 13.059

Type | Location | Fanout | Instance/Net | Source | Dest | Delay (ns)
synccell | U(2,4) | 1 | Rx_1(0)_SYNC | Rx_1(0)_SYNC/clock | Rx_1(0)_SYNC/out | 1.020
Route | | 1 | Net_7_SYNCOUT | Rx_1(0)_SYNC/out | \UART:BUART:pollcount_1\/main_4 | 3.244
macrocell21 | U(3,5) | 1 | \UART:BUART:pollcount_1\ | | SETUP | 3.510
Clock | | | | | Skew | 0.000
Rx_1(0)_SYNC/out | \UART:BUART:rx_status_3\/main_7 | 128.634 MHz | 7.774 | 13.059

Type | Location | Fanout | Instance/Net | Source | Dest | Delay (ns)
synccell | U(2,4) | 1 | Rx_1(0)_SYNC | Rx_1(0)_SYNC/clock | Rx_1(0)_SYNC/out | 1.020
Route | | 1 | Net_7_SYNCOUT | Rx_1(0)_SYNC/out | \UART:BUART:rx_status_3\/main_7 | 3.244
macrocell23 | U(3,5) | 1 | \UART:BUART:rx_status_3\ | | SETUP | 3.510
Clock | | | | | Skew | 0.000
Rx_1(0)_SYNC/out | \UART:BUART:rx_state_0\/main_10 | 129.099 MHz | 7.746 | 13.087

Type | Location | Fanout | Instance/Net | Source | Dest | Delay (ns)
synccell | U(2,4) | 1 | Rx_1(0)_SYNC | Rx_1(0)_SYNC/clock | Rx_1(0)_SYNC/out | 1.020
Route | | 1 | Net_7_SYNCOUT | Rx_1(0)_SYNC/out | \UART:BUART:rx_state_0\/main_10 | 3.216
macrocell15 | U(3,5) | 1 | \UART:BUART:rx_state_0\ | | SETUP | 3.510
Clock | | | | | Skew | 0.000
Rx_1(0)_SYNC/out | \UART:BUART:rx_state_2\/main_9 | 129.099 MHz | 7.746 | 13.087

Type | Location | Fanout | Instance/Net | Source | Dest | Delay (ns)
synccell | U(2,4) | 1 | Rx_1(0)_SYNC | Rx_1(0)_SYNC/clock | Rx_1(0)_SYNC/out | 1.020
Route | | 1 | Net_7_SYNCOUT | Rx_1(0)_SYNC/out | \UART:BUART:rx_state_2\/main_9 | 3.216
macrocell18 | U(3,5) | 1 | \UART:BUART:rx_state_2\ | | SETUP | 3.510
Clock | | | | | Skew | 0.000

+ Source Clock : UART_IntClock : Positive edge(Required Frequency 76.8 kHz)

+ Destination Clock : UART_IntClock : Positive edge(Required Frequency 76.8 kHz)

Path Delay Requirement : 13020.8ns(76.8 kHz)

Source | Destination | FMax | Delay (ns) | Slack (ns) | Violation
\UART:BUART:pollcount_1\/q | \UART:BUART:sRX:RxShifter:u0\/route_si | 48.146 MHz | 20.770 | 13000.063

Type | Location | Fanout | Instance/Net | Source | Dest | Delay (ns)
macrocell21 | U(3,5) | 1 | \UART:BUART:pollcount_1\ | \UART:BUART:pollcount_1\/clock_0 | \UART:BUART:pollcount_1\/q | 1.250
Route | | 1 | \UART:BUART:pollcount_1\ | \UART:BUART:pollcount_1\/q | \UART:BUART:rx_postpoll\/main_0 | 10.411
macrocell6 | U(3,3) | 1 | \UART:BUART:rx_postpoll\ | \UART:BUART:rx_postpoll\/main_0 | \UART:BUART:rx_postpoll\/q | 3.350
Route | | 1 | \UART:BUART:rx_postpoll\ | \UART:BUART:rx_postpoll\/q | \UART:BUART:sRX:RxShifter:u0\/route_si | 2.289
datapathcell3 | U(3,3) | 1 | \UART:BUART:sRX:RxShifter:u0\ | | SETUP | 3.470
Clock | | | | | Skew | 0.000
\UART:BUART:tx_state_0\/q | \UART:BUART:sTX:sCLOCK:TxBitClkGen\/cs_addr_0 | 55.002 MHz | 18.181 | 13002.652

Type | Location | Fanout | Instance/Net | Source | Dest | Delay (ns)
macrocell11 | U(2,3) | 1 | \UART:BUART:tx_state_0\ | \UART:BUART:tx_state_0\/clock_0 | \UART:BUART:tx_state_0\/q | 1.250
Route | | 1 | \UART:BUART:tx_state_0\ | \UART:BUART:tx_state_0\/q | \UART:BUART:counter_load_not\/main_1 | 5.096
macrocell2 | U(2,4) | 1 | \UART:BUART:counter_load_not\ | \UART:BUART:counter_load_not\/main_1 | \UART:BUART:counter_load_not\/q | 3.350
Route | | 1 | \UART:BUART:counter_load_not\ | \UART:BUART:counter_load_not\/q | \UART:BUART:sTX:sCLOCK:TxBitClkGen\/cs_addr_0 | 2.295
datapathcell2 | U(2,4) | 1 | \UART:BUART:sTX:sCLOCK:TxBitClkGen\ | | SETUP | 6.190
Clock | | | | | Skew | 0.000
\UART:BUART:tx_ctrl_mark_last\/q | \UART:BUART:sRX:RxBitCounter\/load | 58.079 MHz | 17.218 | 13003.615

Type | Location | Fanout | Instance/Net | Source | Dest | Delay (ns)
macrocell14 | U(2,5) | 1 | \UART:BUART:tx_ctrl_mark_last\ | \UART:BUART:tx_ctrl_mark_last\/clock_0 | \UART:BUART:tx_ctrl_mark_last\/q | 1.250
Route | | 1 | \UART:BUART:tx_ctrl_mark_last\ | \UART:BUART:tx_ctrl_mark_last\/q | \UART:BUART:rx_counter_load\/main_0 | 4.949
macrocell5 | U(3,5) | 1 | \UART:BUART:rx_counter_load\ | \UART:BUART:rx_counter_load\/main_0 | \UART:BUART:rx_counter_load\/q | 3.350
Route | | 1 | \UART:BUART:rx_counter_load\ | \UART:BUART:rx_counter_load\/q | \UART:BUART:sRX:RxBitCounter\/load | 2.309
count7cell | U(3,5) | 1 | \UART:BUART:sRX:RxBitCounter\ | | SETUP | 5.360
Clock | | | | | Skew | 0.000
\UART:BUART:rx_state_2\/q | \UART:BUART:sRX:RxBitCounter\/load | 59.042 MHz | 16.937 | 13003.896

Type | Location | Fanout | Instance/Net | Source | Dest | Delay (ns)
macrocell18 | U(3,5) | 1 | \UART:BUART:rx_state_2\ | \UART:BUART:rx_state_2\/clock_0 | \UART:BUART:rx_state_2\/q | 1.250
Route | | 1 | \UART:BUART:rx_state_2\ | \UART:BUART:rx_state_2\/q | \UART:BUART:rx_counter_load\/main_3 | 4.668
macrocell5 | U(3,5) | 1 | \UART:BUART:rx_counter_load\ | \UART:BUART:rx_counter_load\/main_3 | \UART:BUART:rx_counter_load\/q | 3.350
Route | | 1 | \UART:BUART:rx_counter_load\ | \UART:BUART:rx_counter_load\/q | \UART:BUART:sRX:RxBitCounter\/load | 2.309
count7cell | U(3,5) | 1 | \UART:BUART:sRX:RxBitCounter\ | | SETUP | 5.360
Clock | | | | | Skew | 0.000
\UART:BUART:rx_state_0\/q | \UART:BUART:sRX:RxBitCounter\/load | 61.113 MHz | 16.363 | 13004.470

Type | Location | Fanout | Instance/Net | Source | Dest | Delay (ns)
macrocell15 | U(3,5) | 1 | \UART:BUART:rx_state_0\ | \UART:BUART:rx_state_0\/clock_0 | \UART:BUART:rx_state_0\/q | 1.250
Route | | 1 | \UART:BUART:rx_state_0\ | \UART:BUART:rx_state_0\/q | \UART:BUART:rx_counter_load\/main_1 | 4.094
macrocell5 | U(3,5) | 1 | \UART:BUART:rx_counter_load\ | \UART:BUART:rx_counter_load\/main_1 | \UART:BUART:rx_counter_load\/q | 3.350
Route | | 1 | \UART:BUART:rx_counter_load\ | \UART:BUART:rx_counter_load\/q | \UART:BUART:sRX:RxBitCounter\/load | 2.309
count7cell | U(3,5) | 1 | \UART:BUART:sRX:RxBitCounter\ | | SETUP | 5.360
Clock | | | | | Skew | 0.000
\UART:BUART:tx_state_1\/q | \UART:BUART:sTX:sCLOCK:TxBitClkGen\/cs_addr_0 | 61.893 MHz | 16.157 | 13004.676

Type | Location | Fanout | Instance/Net | Source | Dest | Delay (ns)
macrocell10 | U(3,4) | 1 | \UART:BUART:tx_state_1\ | \UART:BUART:tx_state_1\/clock_0 | \UART:BUART:tx_state_1\/q | 1.250
Route | | 1 | \UART:BUART:tx_state_1\ | \UART:BUART:tx_state_1\/q | \UART:BUART:counter_load_not\/main_0 | 3.072
macrocell2 | U(2,4) | 1 | \UART:BUART:counter_load_not\ | \UART:BUART:counter_load_not\/main_0 | \UART:BUART:counter_load_not\/q | 3.350
Route | | 1 | \UART:BUART:counter_load_not\ | \UART:BUART:counter_load_not\/q | \UART:BUART:sTX:sCLOCK:TxBitClkGen\/cs_addr_0 | 2.295
datapathcell2 | U(2,4) | 1 | \UART:BUART:sTX:sCLOCK:TxBitClkGen\ | | SETUP | 6.190
Clock | | | | | Skew | 0.000
\UART:BUART:tx_state_2\/q | \UART:BUART:sTX:sCLOCK:TxBitClkGen\/cs_addr_0 | 62.606 MHz | 15.973 | 13004.860

Type | Location | Fanout | Instance/Net | Source | Dest | Delay (ns)
macrocell12 | U(2,4) | 1 | \UART:BUART:tx_state_2\ | \UART:BUART:tx_state_2\/clock_0 | \UART:BUART:tx_state_2\/q | 1.250
Route | | 1 | \UART:BUART:tx_state_2\ | \UART:BUART:tx_state_2\/q | \UART:BUART:counter_load_not\/main_3 | 2.888
macrocell2 | U(2,4) | 1 | \UART:BUART:counter_load_not\ | \UART:BUART:counter_load_not\/main_3 | \UART:BUART:counter_load_not\/q | 3.350
Route | | 1 | \UART:BUART:counter_load_not\ | \UART:BUART:counter_load_not\/q | \UART:BUART:sTX:sCLOCK:TxBitClkGen\/cs_addr_0 | 2.295
datapathcell2 | U(2,4) | 1 | \UART:BUART:sTX:sCLOCK:TxBitClkGen\ | | SETUP | 6.190
Clock | | | | | Skew | 0.000
\UART:BUART:rx_state_3\/q | \UART:BUART:sRX:RxBitCounter\/load | 65.130 MHz | 15.354 | 13005.479

Type | Location | Fanout | Instance/Net | Source | Dest | Delay (ns)
macrocell17 | U(2,5) | 1 | \UART:BUART:rx_state_3\ | \UART:BUART:rx_state_3\/clock_0 | \UART:BUART:rx_state_3\/q | 1.250
Route | | 1 | \UART:BUART:rx_state_3\ | \UART:BUART:rx_state_3\/q | \UART:BUART:rx_counter_load\/main_2 | 3.085
macrocell5 | U(3,5) | 1 | \UART:BUART:rx_counter_load\ | \UART:BUART:rx_counter_load\/main_2 | \UART:BUART:rx_counter_load\/q | 3.350
Route | | 1 | \UART:BUART:rx_counter_load\ | \UART:BUART:rx_counter_load\/q | \UART:BUART:sRX:RxBitCounter\/load | 2.309
count7cell | U(3,5) | 1 | \UART:BUART:sRX:RxBitCounter\ | | SETUP | 5.360
Clock | | | | | Skew | 0.000
\UART:BUART:sTX:sCLOCK:TxBitClkGen\/ce0_reg | \UART:BUART:sTX:sCLOCK:TxBitClkGen\/cs_addr_0 | 65.424 MHz | 15.285 | 13005.548

Type | Location | Fanout | Instance/Net | Source | Dest | Delay (ns)
datapathcell2 | U(2,4) | 1 | \UART:BUART:sTX:sCLOCK:TxBitClkGen\ | \UART:BUART:sTX:sCLOCK:TxBitClkGen\/clock | \UART:BUART:sTX:sCLOCK:TxBitClkGen\/ce0_reg | 0.190
Route | | 1 | \UART:BUART:tx_bitclk_enable_pre\ | \UART:BUART:sTX:sCLOCK:TxBitClkGen\/ce0_reg | \UART:BUART:counter_load_not\/main_2 | 3.260
macrocell2 | U(2,4) | 1 | \UART:BUART:counter_load_not\ | \UART:BUART:counter_load_not\/main_2 | \UART:BUART:counter_load_not\/q | 3.350
Route | | 1 | \UART:BUART:counter_load_not\ | \UART:BUART:counter_load_not\/q | \UART:BUART:sTX:sCLOCK:TxBitClkGen\/cs_addr_0 | 2.295
datapathcell2 | U(2,4) | 1 | \UART:BUART:sTX:sCLOCK:TxBitClkGen\ | | SETUP | 6.190
Clock | | | | | Skew | 0.000
\UART:BUART:rx_state_0\/q | \UART:BUART:sRX:RxShifter:u0\/cs_addr_1 | 66.542 MHz | 15.028 | 13005.805

Type | Location | Fanout | Instance/Net | Source | Dest | Delay (ns)
macrocell15 | U(3,5) | 1 | \UART:BUART:rx_state_0\ | \UART:BUART:rx_state_0\/clock_0 | \UART:BUART:rx_state_0\/q | 1.250
Route | | 1 | \UART:BUART:rx_state_0\ | \UART:BUART:rx_state_0\/q | \UART:BUART:sRX:RxShifter:u0\/cs_addr_1 | 7.768
datapathcell3 | U(3,3) | 1 | \UART:BUART:sRX:RxShifter:u0\ | | SETUP | 6.010
Clock | | | | | Skew | 0.000

+ Hold Subsection

+ Source Clock : CyBUS_CLK : Positive edge

+ Destination Clock : UART_IntClock : Positive edge

Source | Destination | Slack (ns) | Violation
Rx_1(0)_SYNC/out | \UART:BUART:rx_state_0\/main_10 | 3.566

Type | Location | Fanout | Instance/Net | Source | Dest | Delay (ns)
synccell | U(2,4) | 1 | Rx_1(0)_SYNC | Rx_1(0)_SYNC/clock | Rx_1(0)_SYNC/out | 0.350
Route | | 1 | Net_7_SYNCOUT | Rx_1(0)_SYNC/out | \UART:BUART:rx_state_0\/main_10 | 3.216
macrocell15 | U(3,5) | 1 | \UART:BUART:rx_state_0\ | | HOLD | 0.000
Clock | | | | | Skew | 0.000
Rx_1(0)_SYNC/out | \UART:BUART:rx_state_2\/main_9 | 3.566

Type | Location | Fanout | Instance/Net | Source | Dest | Delay (ns)
synccell | U(2,4) | 1 | Rx_1(0)_SYNC | Rx_1(0)_SYNC/clock | Rx_1(0)_SYNC/out | 0.350
Route | | 1 | Net_7_SYNCOUT | Rx_1(0)_SYNC/out | \UART:BUART:rx_state_2\/main_9 | 3.216
macrocell18 | U(3,5) | 1 | \UART:BUART:rx_state_2\ | | HOLD | 0.000
Clock | | | | | Skew | 0.000
Rx_1(0)_SYNC/out | \UART:BUART:pollcount_1\/main_4 | 3.594

Type | Location | Fanout | Instance/Net | Source | Dest | Delay (ns)
synccell | U(2,4) | 1 | Rx_1(0)_SYNC | Rx_1(0)_SYNC/clock | Rx_1(0)_SYNC/out | 0.350
Route | | 1 | Net_7_SYNCOUT | Rx_1(0)_SYNC/out | \UART:BUART:pollcount_1\/main_4 | 3.244
macrocell21 | U(3,5) | 1 | \UART:BUART:pollcount_1\ | | HOLD | 0.000
Clock | | | | | Skew | 0.000
Rx_1(0)_SYNC/out | \UART:BUART:rx_status_3\/main_7 | 3.594

Type | Location | Fanout | Instance/Net | Source | Dest | Delay (ns)
synccell | U(2,4) | 1 | Rx_1(0)_SYNC | Rx_1(0)_SYNC/clock | Rx_1(0)_SYNC/out | 0.350
Route | | 1 | Net_7_SYNCOUT | Rx_1(0)_SYNC/out | \UART:BUART:rx_status_3\/main_7 | 3.244
macrocell23 | U(3,5) | 1 | \UART:BUART:rx_status_3\ | | HOLD | 0.000
Clock | | | | | Skew | 0.000
Rx_1(0)_SYNC/out | \UART:BUART:pollcount_0\/main_3 | 3.606

Type | Location | Fanout | Instance/Net | Source | Dest | Delay (ns)
synccell | U(2,4) | 1 | Rx_1(0)_SYNC | Rx_1(0)_SYNC/clock | Rx_1(0)_SYNC/out | 0.350
Route | | 1 | Net_7_SYNCOUT | Rx_1(0)_SYNC/out | \UART:BUART:pollcount_0\/main_3 | 3.256
macrocell22 | U(3,3) | 1 | \UART:BUART:pollcount_0\ | | HOLD | 0.000
Clock | | | | | Skew | 0.000
Rx_1(0)_SYNC/out | \UART:BUART:rx_last\/main_0 | 3.606

Type | Location | Fanout | Instance/Net | Source | Dest | Delay (ns)
synccell | U(2,4) | 1 | Rx_1(0)_SYNC | Rx_1(0)_SYNC/clock | Rx_1(0)_SYNC/out | 0.350
Route | | 1 | Net_7_SYNCOUT | Rx_1(0)_SYNC/out | \UART:BUART:rx_last\/main_0 | 3.256
macrocell24 | U(3,3) | 1 | \UART:BUART:rx_last\ | | HOLD | 0.000
Clock | | | | | Skew | 0.000
Rx_1(0)_SYNC/out | \UART:BUART:sRX:RxShifter:u0\/route_si | 9.245

Type | Location | Fanout | Instance/Net | Source | Dest | Delay (ns)
synccell | U(2,4) | 1 | Rx_1(0)_SYNC | Rx_1(0)_SYNC/clock | Rx_1(0)_SYNC/out | 0.350
Route | | 1 | Net_7_SYNCOUT | Rx_1(0)_SYNC/out | \UART:BUART:rx_postpoll\/main_2 | 3.256
macrocell6 | U(3,3) | 1 | \UART:BUART:rx_postpoll\ | \UART:BUART:rx_postpoll\/main_2 | \UART:BUART:rx_postpoll\/q | 3.350
Route | | 1 | \UART:BUART:rx_postpoll\ | \UART:BUART:rx_postpoll\/q | \UART:BUART:sRX:RxShifter:u0\/route_si | 2.289
datapathcell3 | U(3,3) | 1 | \UART:BUART:sRX:RxShifter:u0\ | | HOLD | 0.000
Clock | | | | | Skew | 0.000

+ Source Clock : UART_IntClock : Positive edge

+ Destination Clock : UART_IntClock : Positive edge

Source | Destination | Slack (ns) | Violation
\UART:BUART:rx_status_3\/q | \UART:BUART:sRX:RxSts\/status_3 | 2.164

Type | Location | Fanout | Instance/Net | Source | Dest | Delay (ns)
macrocell23 | U(3,5) | 1 | \UART:BUART:rx_status_3\ | \UART:BUART:rx_status_3\/clock_0 | \UART:BUART:rx_status_3\/q | 1.250
Route | | 1 | \UART:BUART:rx_status_3\ | \UART:BUART:rx_status_3\/q | \UART:BUART:sRX:RxSts\/status_3 | 2.914
statusicell2 | U(3,4) | 1 | \UART:BUART:sRX:RxSts\ | | HOLD | -2.000
Clock | | | | | Skew | 0.000
\UART:BUART:sRX:RxBitCounter\/count_0 | \UART:BUART:rx_bitclk_enable\/main_2 | 2.935

Type | Location | Fanout | Instance/Net | Source | Dest | Delay (ns)
count7cell | U(3,5) | 1 | \UART:BUART:sRX:RxBitCounter\ | \UART:BUART:sRX:RxBitCounter\/clock | \UART:BUART:sRX:RxBitCounter\/count_0 | 0.620
Route | | 1 | \UART:BUART:rx_count_0\ | \UART:BUART:sRX:RxBitCounter\/count_0 | \UART:BUART:rx_bitclk_enable\/main_2 | 2.315
macrocell19 | U(3,5) | 1 | \UART:BUART:rx_bitclk_enable\ | | HOLD | 0.000
Clock | | | | | Skew | 0.000
\UART:BUART:sRX:RxBitCounter\/count_2 | \UART:BUART:rx_bitclk_enable\/main_0 | 2.940

Type | Location | Fanout | Instance/Net | Source | Dest | Delay (ns)
count7cell | U(3,5) | 1 | \UART:BUART:sRX:RxBitCounter\ | \UART:BUART:sRX:RxBitCounter\/clock | \UART:BUART:sRX:RxBitCounter\/count_2 | 0.620
Route | | 1 | \UART:BUART:rx_count_2\ | \UART:BUART:sRX:RxBitCounter\/count_2 | \UART:BUART:rx_bitclk_enable\/main_0 | 2.320
macrocell19 | U(3,5) | 1 | \UART:BUART:rx_bitclk_enable\ | | HOLD | 0.000
Clock | | | | | Skew | 0.000
\UART:BUART:sRX:RxBitCounter\/count_2 | \UART:BUART:pollcount_1\/main_0 | 2.940

Type | Location | Fanout | Instance/Net | Source | Dest | Delay (ns)
count7cell | U(3,5) | 1 | \UART:BUART:sRX:RxBitCounter\ | \UART:BUART:sRX:RxBitCounter\/clock | \UART:BUART:sRX:RxBitCounter\/count_2 | 0.620
Route | | 1 | \UART:BUART:rx_count_2\ | \UART:BUART:sRX:RxBitCounter\/count_2 | \UART:BUART:pollcount_1\/main_0 | 2.320
macrocell21 | U(3,5) | 1 | \UART:BUART:pollcount_1\ | | HOLD | 0.000
Clock | | | | | Skew | 0.000
\UART:BUART:sTX:sCLOCK:TxBitClkGen\/ce1_reg | \UART:BUART:tx_state_2\/main_4 | 3.143

Type | Location | Fanout | Instance/Net | Source | Dest | Delay (ns)
datapathcell2 | U(2,4) | 1 | \UART:BUART:sTX:sCLOCK:TxBitClkGen\ | \UART:BUART:sTX:sCLOCK:TxBitClkGen\/clock | \UART:BUART:sTX:sCLOCK:TxBitClkGen\/ce1_reg | 0.190
Route | | 1 | \UART:BUART:tx_counter_dp\ | \UART:BUART:sTX:sCLOCK:TxBitClkGen\/ce1_reg | \UART:BUART:tx_state_2\/main_4 | 2.953
macrocell12 | U(2,4) | 1 | \UART:BUART:tx_state_2\ | | HOLD | 0.000
Clock | | | | | Skew | 0.000
\UART:BUART:sTX:sCLOCK:TxBitClkGen\/ce1_reg | \UART:BUART:txn\/main_5 | 3.264

Type | Location | Fanout | Instance/Net | Source | Dest | Delay (ns)
datapathcell2 | U(2,4) | 1 | \UART:BUART:sTX:sCLOCK:TxBitClkGen\ | \UART:BUART:sTX:sCLOCK:TxBitClkGen\/clock | \UART:BUART:sTX:sCLOCK:TxBitClkGen\/ce1_reg | 0.190
Route | | 1 | \UART:BUART:tx_counter_dp\ | \UART:BUART:sTX:sCLOCK:TxBitClkGen\/ce1_reg | \UART:BUART:txn\/main_5 | 3.074
macrocell9 | U(2,4) | 1 | \UART:BUART:txn\ | | HOLD | 0.000
Clock | | | | | Skew | 0.000
\UART:BUART:sRX:RxBitCounter\/count_1 | \UART:BUART:rx_bitclk_enable\/main_1 | 3.264

Type | Location | Fanout | Instance/Net | Source | Dest | Delay (ns)
count7cell | U(3,5) | 1 | \UART:BUART:sRX:RxBitCounter\ | \UART:BUART:sRX:RxBitCounter\/clock | \UART:BUART:sRX:RxBitCounter\/count_1 | 0.620
Route | | 1 | \UART:BUART:rx_count_1\ | \UART:BUART:sRX:RxBitCounter\/count_1 | \UART:BUART:rx_bitclk_enable\/main_1 | 2.644
macrocell19 | U(3,5) | 1 | \UART:BUART:rx_bitclk_enable\ | | HOLD | 0.000
Clock | | | | | Skew | 0.000
\UART:BUART:sRX:RxBitCounter\/count_1 | \UART:BUART:pollcount_1\/main_1 | 3.264

Type | Location | Fanout | Instance/Net | Source | Dest | Delay (ns)
count7cell | U(3,5) | 1 | \UART:BUART:sRX:RxBitCounter\ | \UART:BUART:sRX:RxBitCounter\/clock | \UART:BUART:sRX:RxBitCounter\/count_1 | 0.620
Route | | 1 | \UART:BUART:rx_count_1\ | \UART:BUART:sRX:RxBitCounter\/count_1 | \UART:BUART:pollcount_1\/main_1 | 2.644
macrocell21 | U(3,5) | 1 | \UART:BUART:pollcount_1\ | | HOLD | 0.000
Clock | | | | | Skew | 0.000
\UART:BUART:sTX:sCLOCK:TxBitClkGen\/ce1_reg | \UART:BUART:tx_state_1\/main_4 | 3.268

Type | Location | Fanout | Instance/Net | Source | Dest | Delay (ns)
datapathcell2 | U(2,4) | 1 | \UART:BUART:sTX:sCLOCK:TxBitClkGen\ | \UART:BUART:sTX:sCLOCK:TxBitClkGen\/clock | \UART:BUART:sTX:sCLOCK:TxBitClkGen\/ce1_reg | 0.190
Route | | 1 | \UART:BUART:tx_counter_dp\ | \UART:BUART:sTX:sCLOCK:TxBitClkGen\/ce1_reg | \UART:BUART:tx_state_1\/main_4 | 3.078
macrocell10 | U(3,4) | 1 | \UART:BUART:tx_state_1\ | | HOLD | 0.000
Clock | | | | | Skew | 0.000
\UART:BUART:sRX:RxBitCounter\/count_6 | \UART:BUART:rx_state_3\/main_5 | 3.277

Type | Location | Fanout | Instance/Net | Source | Dest | Delay (ns)
count7cell | U(3,5) | 1 | \UART:BUART:sRX:RxBitCounter\ | \UART:BUART:sRX:RxBitCounter\/clock | \UART:BUART:sRX:RxBitCounter\/count_6 | 0.620
Route | | 1 | \UART:BUART:rx_count_6\ | \UART:BUART:sRX:RxBitCounter\/count_6 | \UART:BUART:rx_state_3\/main_5 | 2.657
macrocell17 | U(2,5) | 1 | \UART:BUART:rx_state_3\ | | HOLD | 0.000
Clock | | | | | Skew | 0.000

+ Input To Clock Section

+ Clock_RE

Source | Destination | Delay (ns)
Pin_RE_In(0)_PAD | Net_121/main_0 | 17.185

Type | Location | Fanout | Instance/Net | Source | Dest | Delay (ns)
Route | | 1 | Pin_RE_In(0)_PAD | Pin_RE_In(0)_PAD | Pin_RE_In(0)/pad_in | 0.000
iocell16 | P0[0] | 1 | Pin_RE_In(0) | Pin_RE_In(0)/pad_in | Pin_RE_In(0)/fb | 7.922
Route | | 1 | Net_95 | Pin_RE_In(0)/fb | Net_121/main_0 | 5.753
macrocell25 | U(3,4) | 1 | Net_121 | | SETUP | 3.510
Clock | | | | | Clock path delay | 0.000
Pin_RE_In(1)_PAD | Net_116/main_0 | 16.221

Type | Location | Fanout | Instance/Net | Source | Dest | Delay (ns)
Route | | 1 | Pin_RE_In(1)_PAD | Pin_RE_In(1)_PAD | Pin_RE_In(1)/pad_in | 0.000
iocell17 | P0[1] | 1 | Pin_RE_In(1) | Pin_RE_In(1)/pad_in | Pin_RE_In(1)/fb | 7.962
Route | | 1 | Net_113 | Pin_RE_In(1)/fb | Net_116/main_0 | 4.749
macrocell26 | U(3,4) | 1 | Net_116 | | SETUP | 3.510
Clock | | | | | Clock path delay | 0.000

+ Clock To Output Section

+ Clock_I2S(routed)

Source | Destination | Delay (ns)
ClockBlock/dclk_0 | Pin_I2S_Clock(0)_PAD | 19.377

Type | Location | Fanout | Instance/Net | Source | Dest | Delay (ns)
clockblockcell | F(Clock,0) | 1 | ClockBlock | Input Delay | ClockBlock/dclk_0 | 0.000
Route | | 1 | Net_28_local | ClockBlock/dclk_0 | Pin_I2S_Clock(0)/pin_input | 4.497
iocell4 | P0[4] | 1 | Pin_I2S_Clock(0) | Pin_I2S_Clock(0)/pin_input | Pin_I2S_Clock(0)/pad_out | 14.880
Route | | 1 | Pin_I2S_Clock(0)_PAD | Pin_I2S_Clock(0)/pad_out | Pin_I2S_Clock(0)_PAD | 0.000
Clock | | | | | Clock path delay | 0.000
ClockBlock/dclk_0 | Pin_I2S_Clock(0)_PAD | 19.377

Type | Location | Fanout | Instance/Net | Source | Dest | Delay (ns)
clockblockcell | F(Clock,0) | 1 | ClockBlock | Input Delay | ClockBlock/dclk_0 | 0.000
Route | | 1 | Net_28_local | ClockBlock/dclk_0 | Pin_I2S_Clock(0)/pin_input | 4.497
iocell4 | P0[4] | 1 | Pin_I2S_Clock(0) | Pin_I2S_Clock(0)/pin_input | Pin_I2S_Clock(0)/pad_out | 14.880
Route | | 1 | Pin_I2S_Clock(0)_PAD | Pin_I2S_Clock(0)/pad_out | Pin_I2S_Clock(0)_PAD | 0.000
Clock | | | | | Clock path delay | 0.000

+ Clock_RE

Source | Destination | Delay (ns)
Net_116/q | Pin_RE(1)_PAD | 23.287

Type | Location | Fanout | Instance/Net | Source | Dest | Delay (ns)
macrocell26 | U(3,4) | 1 | Net_116 | Net_116/clock_0 | Net_116/q | 1.250
Route | | 1 | Net_116 | Net_116/q | Pin_RE(1)/pin_input | 6.293
iocell19 | P0[3] | 1 | Pin_RE(1) | Pin_RE(1)/pin_input | Pin_RE(1)/pad_out | 15.744
Route | | 1 | Pin_RE(1)_PAD | Pin_RE(1)/pad_out | Pin_RE(1)_PAD | 0.000
Clock | | | | | Clock path delay | 0.000
Net_121/q | Pin_RE(0)_PAD | 22.229

Type | Location | Fanout | Instance/Net | Source | Dest | Delay (ns)
macrocell25 | U(3,4) | 1 | Net_121 | Net_121/clock_0 | Net_121/q | 1.250
Route | | 1 | Net_121 | Net_121/q | Pin_RE(0)/pin_input | 5.520
iocell18 | P0[2] | 1 | Pin_RE(0) | Pin_RE(0)/pin_input | Pin_RE(0)/pad_out | 15.459
Route | | 1 | Pin_RE(0)_PAD | Pin_RE(0)/pad_out | Pin_RE(0)_PAD | 0.000
Clock | | | | | Clock path delay | 0.000

+ CyBUS_CLK(fixed-function)

Source | Destination | Delay (ns)
\I2CM_LCD:I2C_FF\/sda_out | Pin_I2C_SDA(0)_PAD:out | 23.826

Type | Location | Fanout | Instance/Net | Source | Dest | Delay (ns)
i2ccell | F(I2C,0) | 1 | \I2CM_LCD:I2C_FF\ | \I2CM_LCD:I2C_FF\/clock | \I2CM_LCD:I2C_FF\/sda_out | 1.000
Route | | 1 | \I2CM_LCD:sda_x_wire\ | \I2CM_LCD:I2C_FF\/sda_out | Pin_I2C_SDA(0)/pin_input | 7.847
iocell6 | P3[1] | 1 | Pin_I2C_SDA(0) | Pin_I2C_SDA(0)/pin_input | Pin_I2C_SDA(0)/pad_out | 14.979
Route | | 1 | Pin_I2C_SDA(0)_PAD | Pin_I2C_SDA(0)/pad_out | Pin_I2C_SDA(0)_PAD:out | 0.000
Clock | | | | | Clock path delay | 0.000
\I2CM_LCD:I2C_FF\/scl_out | Pin_I2C_SCL(0)_PAD:out | 23.567

Type | Location | Fanout | Instance/Net | Source | Dest | Delay (ns)
i2ccell | F(I2C,0) | 1 | \I2CM_LCD:I2C_FF\ | \I2CM_LCD:I2C_FF\/clock | \I2CM_LCD:I2C_FF\/scl_out | 1.000
Route | | 1 | \I2CM_LCD:Net_643_0\ | \I2CM_LCD:I2C_FF\/scl_out | Pin_I2C_SCL(0)/pin_input | 7.947
iocell5 | P3[0] | 1 | Pin_I2C_SCL(0) | Pin_I2C_SCL(0)/pin_input | Pin_I2C_SCL(0)/pad_out | 14.620
Route | | 1 | Pin_I2C_SCL(0)_PAD | Pin_I2C_SCL(0)/pad_out | Pin_I2C_SCL(0)_PAD:out | 0.000
Clock | | | | | Clock path delay | 0.000

+ UART_IntClock

Source | Destination | Delay (ns)
\UART:BUART:txn\/q | Tx_1(0)_PAD | 33.053

Type | Location | Fanout | Instance/Net | Source | Dest | Delay (ns)
macrocell9 | U(2,4) | 1 | \UART:BUART:txn\ | \UART:BUART:txn\/clock_0 | \UART:BUART:txn\/q | 1.250
Route | | 1 | \UART:BUART:txn\ | \UART:BUART:txn\/q | Net_2/main_0 | 3.218
macrocell1 | U(2,3) | 1 | Net_2 | Net_2/main_0 | Net_2/q | 3.350
Route | | 1 | Net_2 | Net_2/q | Tx_1(0)/pin_input | 8.268
iocell2 | P12[7] | 1 | Tx_1(0) | Tx_1(0)/pin_input | Tx_1(0)/pad_out | 16.967
Route | | 1 | Tx_1(0)_PAD | Tx_1(0)/pad_out | Tx_1(0)_PAD | 0.000
Clock | | | | | Clock path delay | 0.000
