ryood/I2S_FG/PSoC/I2S_FG/PrototypingKit_FG_Test.cydsn/PrototypingKit_FG_Test_timing.html

# Static Timing Analysis

Project : | PrototypingKit_FG_Test
Build Time : | 02/24/16 12:00:07
Device : | CY8C5888LTI-LP097
Temperature : | 0C - 85/125C
VDDA : | 5.00
VDDABUF : | 5.00
VDDD : | 5.00
VDDIO0 : | 5.00
VDDIO1 : | 5.00
VDDIO2 : | 5.00
VDDIO3 : | 5.00
VUSB : | 5.00
Voltage : | 5.0

Expand All | Collapse All | Show All Paths | Hide All Paths

+ Timing Violation Section

Note: If your design will only ever run at typical room temperatures, selecting the narrower temperature range in the system DWR for your application helps the tool to find timing-compliant routing solutions.

Violation | Source Clock | Destination Clock | Slack(ns)
Setup
| CyBUS_CLK | CyBUS_CLK | -2.369

+ Clock Summary Section

Clock | Domain | Nominal Frequency | Required Frequency | Maximum Frequency | Violation
ADC_DelSig_Supply_Ext_CP_Clk | ADC_DelSig_Supply_Ext_CP_Clk | 80.000 MHz | 80.000 MHz | N/A
ADC_DelSig_Supply_Ext_CP_Clk(routed) | ADC_DelSig_Supply_Ext_CP_Clk(routed) | 80.000 MHz | 80.000 MHz | N/A
ADC_DelSig_Supply_theACLK(fixed-function) | ADC_DelSig_Supply_theACLK(fixed-function) | 320.000 kHz | 320.000 kHz | N/A
CyBUS_CLK(fixed-function) | CyBUS_CLK(fixed-function) | 80.000 MHz | 80.000 MHz | N/A
CyILO | CyILO | 1.000 kHz | 1.000 kHz | N/A
CyIMO | CyIMO | 20.000 MHz | 20.000 MHz | N/A
CyMASTER_CLK | CyMASTER_CLK | 80.000 MHz | 80.000 MHz | N/A
CyBUS_CLK | CyMASTER_CLK | 80.000 MHz | 80.000 MHz | 67.254 MHz | Frequency
ADC_DelSig_Supply_theACLK | CyMASTER_CLK | 320.000 kHz | 320.000 kHz | N/A
Clock_2 | CyMASTER_CLK | 100.000 kHz | 100.000 kHz | N/A
Clock_1 | CyMASTER_CLK | 40.000 MHz | 40.000 MHz | 106.394 MHz
CyPLL_OUT | CyPLL_OUT | 80.000 MHz | 80.000 MHz | N/A
CyXTAL | CyXTAL | 20.000 MHz | 20.000 MHz | N/A
\ADC_DelSig_Supply:DSM\/dec_clock | \ADC_DelSig_Supply:DSM\/dec_clock | UNKNOWN | UNKNOWN | N/A

+ Register to Register Section

+ Setup Subsection

+ Source Clock : Clock_1 : Positive edge(Required Frequency 40 MHz)

+ Destination Clock : Clock_1 : Positive edge(Required Frequency 40 MHz)

Path Delay Requirement : 25ns(40 MHz)

Source | Destination | FMax | Delay (ns) | Slack (ns) | Violation
\I2S_1:bI2S:Tx:CH[0]:dpTx:u0\/f0_blk_stat_comb | \I2S_1:bI2S:Tx:STS[0]:Sts\/status_0 | 106.394 MHz | 9.399 | 15.601

Type | Location | Fanout | Instance/Net | Source | Dest | Delay (ns)
datapathcell1 | U(2,1) | 1 | \I2S_1:bI2S:Tx:CH[0]:dpTx:u0\ | \I2S_1:bI2S:Tx:CH[0]:dpTx:u0\/clock | \I2S_1:bI2S:Tx:CH[0]:dpTx:u0\/f0_blk_stat_comb | 2.510
Route | | 1 | \I2S_1:bI2S:tx_f0_empty_0\ | \I2S_1:bI2S:Tx:CH[0]:dpTx:u0\/f0_blk_stat_comb | \I2S_1:bI2S:tx_underflow_0\/main_3 | 2.090
macrocell1 | U(2,1) | 1 | \I2S_1:bI2S:tx_underflow_0\ | \I2S_1:bI2S:tx_underflow_0\/main_3 | \I2S_1:bI2S:tx_underflow_0\/q | 2.345
Route | | 1 | \I2S_1:bI2S:tx_underflow_0\ | \I2S_1:bI2S:tx_underflow_0\/q | \I2S_1:bI2S:Tx:STS[0]:Sts\/status_0 | 2.104
statusicell1 | U(2,1) | 1 | \I2S_1:bI2S:Tx:STS[0]:Sts\ | | SETUP | 0.350
Clock | | | | | Skew | 0.000
\I2S_1:bI2S:tx_state_1\/q | \I2S_1:bI2S:Tx:STS[0]:Sts\/status_0 | 114.286 MHz | 8.750 | 16.250

Type | Location | Fanout | Instance/Net | Source | Dest | Delay (ns)
macrocell8 | U(3,1) | 1 | \I2S_1:bI2S:tx_state_1\ | \I2S_1:bI2S:tx_state_1\/clock_0 | \I2S_1:bI2S:tx_state_1\/q | 0.875
Route | | 1 | \I2S_1:bI2S:tx_state_1\ | \I2S_1:bI2S:tx_state_1\/q | \I2S_1:bI2S:tx_underflow_0\/main_1 | 3.076
macrocell1 | U(2,1) | 1 | \I2S_1:bI2S:tx_underflow_0\ | \I2S_1:bI2S:tx_underflow_0\/main_1 | \I2S_1:bI2S:tx_underflow_0\/q | 2.345
Route | | 1 | \I2S_1:bI2S:tx_underflow_0\ | \I2S_1:bI2S:tx_underflow_0\/q | \I2S_1:bI2S:Tx:STS[0]:Sts\/status_0 | 2.104
statusicell1 | U(2,1) | 1 | \I2S_1:bI2S:Tx:STS[0]:Sts\ | | SETUP | 0.350
Clock | | | | | Skew | 0.000
\I2S_1:bI2S:tx_state_0\/q | \I2S_1:bI2S:Tx:STS[0]:Sts\/status_0 | 114.351 MHz | 8.745 | 16.255

Type | Location | Fanout | Instance/Net | Source | Dest | Delay (ns)
macrocell9 | U(3,1) | 1 | \I2S_1:bI2S:tx_state_0\ | \I2S_1:bI2S:tx_state_0\/clock_0 | \I2S_1:bI2S:tx_state_0\/q | 0.875
Route | | 1 | \I2S_1:bI2S:tx_state_0\ | \I2S_1:bI2S:tx_state_0\/q | \I2S_1:bI2S:tx_underflow_0\/main_2 | 3.071
macrocell1 | U(2,1) | 1 | \I2S_1:bI2S:tx_underflow_0\ | \I2S_1:bI2S:tx_underflow_0\/main_2 | \I2S_1:bI2S:tx_underflow_0\/q | 2.345
Route | | 1 | \I2S_1:bI2S:tx_underflow_0\ | \I2S_1:bI2S:tx_underflow_0\/q | \I2S_1:bI2S:Tx:STS[0]:Sts\/status_0 | 2.104
statusicell1 | U(2,1) | 1 | \I2S_1:bI2S:Tx:STS[0]:Sts\ | | SETUP | 0.350
Clock | | | | | Skew | 0.000
\I2S_1:bI2S:tx_state_2\/q | \I2S_1:bI2S:Tx:STS[0]:Sts\/status_0 | 117.192 MHz | 8.533 | 16.467

Type | Location | Fanout | Instance/Net | Source | Dest | Delay (ns)
macrocell7 | U(3,1) | 1 | \I2S_1:bI2S:tx_state_2\ | \I2S_1:bI2S:tx_state_2\/clock_0 | \I2S_1:bI2S:tx_state_2\/q | 0.875
Route | | 1 | \I2S_1:bI2S:tx_state_2\ | \I2S_1:bI2S:tx_state_2\/q | \I2S_1:bI2S:tx_underflow_0\/main_0 | 2.859
macrocell1 | U(2,1) | 1 | \I2S_1:bI2S:tx_underflow_0\ | \I2S_1:bI2S:tx_underflow_0\/main_0 | \I2S_1:bI2S:tx_underflow_0\/q | 2.345
Route | | 1 | \I2S_1:bI2S:tx_underflow_0\ | \I2S_1:bI2S:tx_underflow_0\/q | \I2S_1:bI2S:Tx:STS[0]:Sts\/status_0 | 2.104
statusicell1 | U(2,1) | 1 | \I2S_1:bI2S:Tx:STS[0]:Sts\ | | SETUP | 0.350
Clock | | | | | Skew | 0.000
\I2S_1:bI2S:CtlReg\/control_2 | \I2S_1:bI2S:BitCounter\/enable | 118.357 MHz | 8.449 | 16.551

Type | Location | Fanout | Instance/Net | Source | Dest | Delay (ns)
controlcell1 | U(2,1) | 1 | \I2S_1:bI2S:CtlReg\ | \I2S_1:bI2S:CtlReg\/clock | \I2S_1:bI2S:CtlReg\/control_2 | 0.847
Route | | 1 | \I2S_1:bI2S:ctrl_2\ | \I2S_1:bI2S:CtlReg\/control_2 | \I2S_1:bI2S:BitCounter\/enable | 4.762
count7cell | U(3,1) | 1 | \I2S_1:bI2S:BitCounter\ | | SETUP | 2.840
Clock | | | | | Skew | 0.000
\I2S_1:bI2S:tx_state_0\/q | \I2S_1:bI2S:Tx:CH[0]:dpTx:u0\/cs_addr_0 | 120.598 MHz | 8.292 | 16.708

Type | Location | Fanout | Instance/Net | Source | Dest | Delay (ns)
macrocell9 | U(3,1) | 1 | \I2S_1:bI2S:tx_state_0\ | \I2S_1:bI2S:tx_state_0\/clock_0 | \I2S_1:bI2S:tx_state_0\/q | 0.875
Route | | 1 | \I2S_1:bI2S:tx_state_0\ | \I2S_1:bI2S:tx_state_0\/q | \I2S_1:bI2S:Tx:CH[0]:dpTx:u0\/cs_addr_0 | 3.087
datapathcell1 | U(2,1) | 1 | \I2S_1:bI2S:Tx:CH[0]:dpTx:u0\ | | SETUP | 4.330
Clock | | | | | Skew | 0.000
\I2S_1:bI2S:tx_state_1\/q | \I2S_1:bI2S:Tx:CH[0]:dpTx:u0\/cs_addr_1 | 120.671 MHz | 8.287 | 16.713

Type | Location | Fanout | Instance/Net | Source | Dest | Delay (ns)
macrocell8 | U(3,1) | 1 | \I2S_1:bI2S:tx_state_1\ | \I2S_1:bI2S:tx_state_1\/clock_0 | \I2S_1:bI2S:tx_state_1\/q | 0.875
Route | | 1 | \I2S_1:bI2S:tx_state_1\ | \I2S_1:bI2S:tx_state_1\/q | \I2S_1:bI2S:Tx:CH[0]:dpTx:u0\/cs_addr_1 | 3.082
datapathcell1 | U(2,1) | 1 | \I2S_1:bI2S:Tx:CH[0]:dpTx:u0\ | | SETUP | 4.330
Clock | | | | | Skew | 0.000
\I2S_1:bI2S:tx_state_2\/q | \I2S_1:bI2S:Tx:CH[0]:dpTx:u0\/cs_addr_2 | 125.881 MHz | 7.944 | 17.056

Type | Location | Fanout | Instance/Net | Source | Dest | Delay (ns)
macrocell7 | U(3,1) | 1 | \I2S_1:bI2S:tx_state_2\ | \I2S_1:bI2S:tx_state_2\/clock_0 | \I2S_1:bI2S:tx_state_2\/q | 0.875
Route | | 1 | \I2S_1:bI2S:tx_state_2\ | \I2S_1:bI2S:tx_state_2\/q | \I2S_1:bI2S:Tx:CH[0]:dpTx:u0\/cs_addr_2 | 2.739
datapathcell1 | U(2,1) | 1 | \I2S_1:bI2S:Tx:CH[0]:dpTx:u0\ | | SETUP | 4.330
Clock | | | | | Skew | 0.000
\I2S_1:bI2S:BitCounter\/count_0 | \I2S_1:bI2S:txenable\/main_8 | 130.685 MHz | 7.652 | 17.348

Type | Location | Fanout | Instance/Net | Source | Dest | Delay (ns)
count7cell | U(3,1) | 1 | \I2S_1:bI2S:BitCounter\ | \I2S_1:bI2S:BitCounter\/clock | \I2S_1:bI2S:BitCounter\/count_0 | 1.360
Route | | 1 | Net_3 | \I2S_1:bI2S:BitCounter\/count_0 | \I2S_1:bI2S:txenable\/main_8 | 3.835
macrocell6 | U(3,1) | 1 | \I2S_1:bI2S:txenable\ | | SETUP | 2.457
Clock | | | | | Skew | 0.000
\I2S_1:bI2S:CtlReg\/control_2 | \I2S_1:bI2S:reset\/main_0 | 140.292 MHz | 7.128 | 17.872

Type | Location | Fanout | Instance/Net | Source | Dest | Delay (ns)
controlcell1 | U(2,1) | 1 | \I2S_1:bI2S:CtlReg\ | \I2S_1:bI2S:CtlReg\/clock | \I2S_1:bI2S:CtlReg\/control_2 | 0.847
Route | | 1 | \I2S_1:bI2S:ctrl_2\ | \I2S_1:bI2S:CtlReg\/control_2 | \I2S_1:bI2S:reset\/main_0 | 3.824
macrocell3 | U(2,1) | 1 | \I2S_1:bI2S:reset\ | | SETUP | 2.457
Clock | | | | | Skew | 0.000

+ Source Clock : CyBUS_CLK : Positive edge(Required Frequency 80 MHz)

+ Destination Clock : CyBUS_CLK : Positive edge(Required Frequency 80 MHz)

Path Delay Requirement : 12.5ns(80 MHz)

Source | Destination | FMax | Delay (ns) | Slack (ns) | Violation
\I2S_1:bI2S:Tx:CH[0]:dpTx:u0\/f0_bus_stat_comb | DMA_0/dmareq | 67.254 MHz | 14.869 | -2.369 | SETUP

Type | Location | Fanout | Instance/Net | Source | Dest | Delay (ns)
datapathcell1 | U(2,1) | 1 | \I2S_1:bI2S:Tx:CH[0]:dpTx:u0\ | \I2S_1:bI2S:Tx:CH[0]:dpTx:u0\/busclk | \I2S_1:bI2S:Tx:CH[0]:dpTx:u0\/f0_bus_stat_comb | 2.180
Route | | 1 | Net_73_0 | \I2S_1:bI2S:Tx:CH[0]:dpTx:u0\/f0_bus_stat_comb | DMA_0/dmareq | 7.719
drqcell1 | [DrqContainer=(0)][DrqId=(0)] | 1 | DMA_0 | | SETUP | 4.970
Clock | | | | | Skew | 0.000

+ Hold Subsection

+ Source Clock : Clock_1 : Positive edge

+ Destination Clock : Clock_1 : Positive edge

Source | Destination | Slack (ns) | Violation
\I2S_1:bI2S:BitCounter\/count_5 | \I2S_1:bI2S:txenable\/main_3 | 2.536

Type | Location | Fanout | Instance/Net | Source | Dest | Delay (ns)
count7cell | U(3,1) | 1 | \I2S_1:bI2S:BitCounter\ | \I2S_1:bI2S:BitCounter\/clock | \I2S_1:bI2S:BitCounter\/count_5 | 0.430
Route | | 1 | \I2S_1:bI2S:count_5\ | \I2S_1:bI2S:BitCounter\/count_5 | \I2S_1:bI2S:txenable\/main_3 | 2.106
macrocell6 | U(3,1) | 1 | \I2S_1:bI2S:txenable\ | | HOLD | 0.000
Clock | | | | | Skew | 0.000
\I2S_1:bI2S:BitCounter\/count_4 | \I2S_1:bI2S:txenable\/main_4 | 2.558

Type | Location | Fanout | Instance/Net | Source | Dest | Delay (ns)
count7cell | U(3,1) | 1 | \I2S_1:bI2S:BitCounter\ | \I2S_1:bI2S:BitCounter\/clock | \I2S_1:bI2S:BitCounter\/count_4 | 0.430
Route | | 1 | \I2S_1:bI2S:count_4\ | \I2S_1:bI2S:BitCounter\/count_4 | \I2S_1:bI2S:txenable\/main_4 | 2.128
macrocell6 | U(3,1) | 1 | \I2S_1:bI2S:txenable\ | | HOLD | 0.000
Clock | | | | | Skew | 0.000
\I2S_1:bI2S:Tx:CH[0]:dpTx:u0\/so_comb | Net_5_0/main_1 | 2.676

Type | Location | Fanout | Instance/Net | Source | Dest | Delay (ns)
datapathcell1 | U(2,1) | 1 | \I2S_1:bI2S:Tx:CH[0]:dpTx:u0\ | \I2S_1:bI2S:Tx:CH[0]:dpTx:u0\/clock | \I2S_1:bI2S:Tx:CH[0]:dpTx:u0\/so_comb | 0.560
Route | | 1 | \I2S_1:bI2S:tx_data_out_0\ | \I2S_1:bI2S:Tx:CH[0]:dpTx:u0\/so_comb | Net_5_0/main_1 | 2.116
macrocell10 | U(2,1) | 1 | Net_5_0 | | HOLD | 0.000
Clock | | | | | Skew | 0.000
\I2S_1:bI2S:BitCounter\/count_2 | \I2S_1:bI2S:tx_state_1\/main_2 | 2.836

Type | Location | Fanout | Instance/Net | Source | Dest | Delay (ns)
count7cell | U(3,1) | 1 | \I2S_1:bI2S:BitCounter\ | \I2S_1:bI2S:BitCounter\/clock | \I2S_1:bI2S:BitCounter\/count_2 | 0.430
Route | | 1 | \I2S_1:bI2S:count_2\ | \I2S_1:bI2S:BitCounter\/count_2 | \I2S_1:bI2S:tx_state_1\/main_2 | 2.406
macrocell8 | U(3,1) | 1 | \I2S_1:bI2S:tx_state_1\ | | HOLD | 0.000
Clock | | | | | Skew | 0.000
\I2S_1:bI2S:BitCounter\/count_2 | \I2S_1:bI2S:tx_state_0\/main_2 | 2.836

Type | Location | Fanout | Instance/Net | Source | Dest | Delay (ns)
count7cell | U(3,1) | 1 | \I2S_1:bI2S:BitCounter\ | \I2S_1:bI2S:BitCounter\/clock | \I2S_1:bI2S:BitCounter\/count_2 | 0.430
Route | | 1 | \I2S_1:bI2S:count_2\ | \I2S_1:bI2S:BitCounter\/count_2 | \I2S_1:bI2S:tx_state_0\/main_2 | 2.406
macrocell9 | U(3,1) | 1 | \I2S_1:bI2S:tx_state_0\ | | HOLD | 0.000
Clock | | | | | Skew | 0.000
\I2S_1:bI2S:BitCounter\/count_6 | Net_4/main_1 | 2.838

Type | Location | Fanout | Instance/Net | Source | Dest | Delay (ns)
count7cell | U(3,1) | 1 | \I2S_1:bI2S:BitCounter\ | \I2S_1:bI2S:BitCounter\/clock | \I2S_1:bI2S:BitCounter\/count_6 | 0.430
Route | | 1 | \I2S_1:bI2S:count_6\ | \I2S_1:bI2S:BitCounter\/count_6 | Net_4/main_1 | 2.408
macrocell4 | U(3,1) | 1 | Net_4 | | HOLD | 0.000
Clock | | | | | Skew | 0.000
\I2S_1:bI2S:BitCounter\/count_6 | \I2S_1:bI2S:tx_state_1\/main_0 | 2.838

Type | Location | Fanout | Instance/Net | Source | Dest | Delay (ns)
count7cell | U(3,1) | 1 | \I2S_1:bI2S:BitCounter\ | \I2S_1:bI2S:BitCounter\/clock | \I2S_1:bI2S:BitCounter\/count_6 | 0.430
Route | | 1 | \I2S_1:bI2S:count_6\ | \I2S_1:bI2S:BitCounter\/count_6 | \I2S_1:bI2S:tx_state_1\/main_0 | 2.408
macrocell8 | U(3,1) | 1 | \I2S_1:bI2S:tx_state_1\ | | HOLD | 0.000
Clock | | | | | Skew | 0.000
\I2S_1:bI2S:BitCounter\/count_6 | \I2S_1:bI2S:tx_state_0\/main_0 | 2.838

Type | Location | Fanout | Instance/Net | Source | Dest | Delay (ns)
count7cell | U(3,1) | 1 | \I2S_1:bI2S:BitCounter\ | \I2S_1:bI2S:BitCounter\/clock | \I2S_1:bI2S:BitCounter\/count_6 | 0.430
Route | | 1 | \I2S_1:bI2S:count_6\ | \I2S_1:bI2S:BitCounter\/count_6 | \I2S_1:bI2S:tx_state_0\/main_0 | 2.408
macrocell9 | U(3,1) | 1 | \I2S_1:bI2S:tx_state_0\ | | HOLD | 0.000
Clock | | | | | Skew | 0.000
\I2S_1:bI2S:BitCounter\/count_2 | \I2S_1:bI2S:txenable\/main_6 | 2.850

Type | Location | Fanout | Instance/Net | Source | Dest | Delay (ns)
count7cell | U(3,1) | 1 | \I2S_1:bI2S:BitCounter\ | \I2S_1:bI2S:BitCounter\/clock | \I2S_1:bI2S:BitCounter\/count_2 | 0.430
Route | | 1 | \I2S_1:bI2S:count_2\ | \I2S_1:bI2S:BitCounter\/count_2 | \I2S_1:bI2S:txenable\/main_6 | 2.420
macrocell6 | U(3,1) | 1 | \I2S_1:bI2S:txenable\ | | HOLD | 0.000
Clock | | | | | Skew | 0.000
\I2S_1:bI2S:BitCounter\/count_6 | \I2S_1:bI2S:txenable\/main_2 | 2.853

Type | Location | Fanout | Instance/Net | Source | Dest | Delay (ns)
count7cell | U(3,1) | 1 | \I2S_1:bI2S:BitCounter\ | \I2S_1:bI2S:BitCounter\/clock | \I2S_1:bI2S:BitCounter\/count_6 | 0.430
Route | | 1 | \I2S_1:bI2S:count_6\ | \I2S_1:bI2S:BitCounter\/count_6 | \I2S_1:bI2S:txenable\/main_2 | 2.423
macrocell6 | U(3,1) | 1 | \I2S_1:bI2S:txenable\ | | HOLD | 0.000
Clock | | | | | Skew | 0.000

+ Source Clock : CyBUS_CLK : Positive edge

+ Destination Clock : CyBUS_CLK : Positive edge

Source | Destination | Slack (ns) | Violation
\I2S_1:bI2S:Tx:CH[0]:dpTx:u0\/f0_bus_stat_comb | DMA_0/dmareq | 9.899

Type | Location | Fanout | Instance/Net | Source | Dest | Delay (ns)
datapathcell1 | U(2,1) | 1 | \I2S_1:bI2S:Tx:CH[0]:dpTx:u0\ | \I2S_1:bI2S:Tx:CH[0]:dpTx:u0\/busclk | \I2S_1:bI2S:Tx:CH[0]:dpTx:u0\/f0_bus_stat_comb | 2.180
Route | | 1 | Net_73_0 | \I2S_1:bI2S:Tx:CH[0]:dpTx:u0\/f0_bus_stat_comb | DMA_0/dmareq | 7.719
drqcell1 | [DrqContainer=(0)][DrqId=(0)] | 1 | DMA_0 | | HOLD | 0.000
Clock | | | | | Skew | 0.000

+ Input To Clock Section

+ Clock_2

Source | Destination | Delay (ns)
Pin_RE1_IN(1)_PAD | Net_257/main_0 | 15.788

Type | Location | Fanout | Instance/Net | Source | Dest | Delay (ns)
Route | | 1 | Pin_RE1_IN(1)_PAD | Pin_RE1_IN(1)_PAD | Pin_RE1_IN(1)/pad_in | 0.000
iocell20 | P0[1] | 1 | Pin_RE1_IN(1) | Pin_RE1_IN(1)/pad_in | Pin_RE1_IN(1)/fb | 7.962
Route | | 1 | Net_264 | Pin_RE1_IN(1)/fb | Net_257/main_0 | 5.369
macrocell12 | U(3,4) | 1 | Net_257 | | SETUP | 2.457
Clock | | | | | Clock path delay | 0.000
Pin_RE1_IN(0)_PAD | Net_266/main_0 | 14.851

Type | Location | Fanout | Instance/Net | Source | Dest | Delay (ns)
Route | | 1 | Pin_RE1_IN(0)_PAD | Pin_RE1_IN(0)_PAD | Pin_RE1_IN(0)/pad_in | 0.000
iocell19 | P0[0] | 1 | Pin_RE1_IN(0) | Pin_RE1_IN(0)/pad_in | Pin_RE1_IN(0)/fb | 7.922
Route | | 1 | Net_243 | Pin_RE1_IN(0)/fb | Net_266/main_0 | 4.472
macrocell11 | U(3,4) | 1 | Net_266 | | SETUP | 2.457
Clock | | | | | Clock path delay | 0.000

+ Clock To Output Section

+ Clock_1

Source | Destination | Delay (ns)
\I2S_1:bI2S:BitCounter\/count_0 | SCK_1(0)_PAD | 24.796

Type | Location | Fanout | Instance/Net | Source | Dest | Delay (ns)
count7cell | U(3,1) | 1 | \I2S_1:bI2S:BitCounter\ | \I2S_1:bI2S:BitCounter\/clock | \I2S_1:bI2S:BitCounter\/count_0 | 1.360
Route | | 1 | Net_3 | \I2S_1:bI2S:BitCounter\/count_0 | SCK_1(0)/pin_input | 8.055
iocell2 | P1[7] | 1 | SCK_1(0) | SCK_1(0)/pin_input | SCK_1(0)/pad_out | 15.381
Route | | 1 | SCK_1(0)_PAD | SCK_1(0)/pad_out | SCK_1(0)_PAD | 0.000
Clock | | | | | Clock path delay | 0.000
Net_5_0/q | SDO_1(0)_PAD | 23.456

Type | Location | Fanout | Instance/Net | Source | Dest | Delay (ns)
macrocell10 | U(2,1) | 1 | Net_5_0 | Net_5_0/clock_0 | Net_5_0/q | 0.875
Route | | 1 | Net_5_0 | Net_5_0/q | SDO_1(0)/pin_input | 7.510
iocell1 | P1[6] | 1 | SDO_1(0) | SDO_1(0)/pin_input | SDO_1(0)/pad_out | 15.071
Route | | 1 | SDO_1(0)_PAD | SDO_1(0)/pad_out | SDO_1(0)_PAD | 0.000
Clock | | | | | Clock path delay | 0.000
Net_4/q | WS_1(0)_PAD | 23.398

Type | Location | Fanout | Instance/Net | Source | Dest | Delay (ns)
macrocell4 | U(3,1) | 1 | Net_4 | Net_4/clock_0 | Net_4/q | 0.875
Route | | 1 | Net_4 | Net_4/q | WS_1(0)/pin_input | 7.181
iocell3 | P1[5] | 1 | WS_1(0) | WS_1(0)/pin_input | WS_1(0)/pad_out | 15.342
Route | | 1 | WS_1(0)_PAD | WS_1(0)/pad_out | WS_1(0)_PAD | 0.000
Clock | | | | | Clock path delay | 0.000

+ Clock_2

Source | Destination | Delay (ns)
Net_257/q | Pin_RE1(1)_PAD | 22.972

Type | Location | Fanout | Instance/Net | Source | Dest | Delay (ns)
macrocell12 | U(3,4) | 1 | Net_257 | Net_257/clock_0 | Net_257/q | 0.875
Route | | 1 | Net_257 | Net_257/q | Pin_RE1(1)/pin_input | 6.353
iocell22 | P0[3] | 1 | Pin_RE1(1) | Pin_RE1(1)/pin_input | Pin_RE1(1)/pad_out | 15.744
Route | | 1 | Pin_RE1(1)_PAD | Pin_RE1(1)/pad_out | Pin_RE1(1)_PAD | 0.000
Clock | | | | | Clock path delay | 0.000
Net_266/q | Pin_RE1(0)_PAD | 21.779

Type | Location | Fanout | Instance/Net | Source | Dest | Delay (ns)
macrocell11 | U(3,4) | 1 | Net_266 | Net_266/clock_0 | Net_266/q | 0.875
Route | | 1 | Net_266 | Net_266/q | Pin_RE1(0)/pin_input | 5.445
iocell21 | P0[2] | 1 | Pin_RE1(0) | Pin_RE1(0)/pin_input | Pin_RE1(0)/pad_out | 15.459
Route | | 1 | Pin_RE1(0)_PAD | Pin_RE1(0)/pad_out | Pin_RE1(0)_PAD | 0.000
Clock | | | | | Clock path delay | 0.000

+ CyBUS_CLK(fixed-function)

Source | Destination | Delay (ns)
\I2CM_LCD:I2C_FF\/scl_out | Pin_I2C_SCL(0)_PAD:out | 23.898

Type | Location | Fanout | Instance/Net | Source | Dest | Delay (ns)
i2ccell | F(I2C,0) | 1 | \I2CM_LCD:I2C_FF\ | \I2CM_LCD:I2C_FF\/clock | \I2CM_LCD:I2C_FF\/scl_out | 1.000
Route | | 1 | \I2CM_LCD:Net_643_0\ | \I2CM_LCD:I2C_FF\/scl_out | Pin_I2C_SCL(0)/pin_input | 7.919
iocell16 | P3[1] | 1 | Pin_I2C_SCL(0) | Pin_I2C_SCL(0)/pin_input | Pin_I2C_SCL(0)/pad_out | 14.979
Route | | 1 | Pin_I2C_SCL(0)_PAD | Pin_I2C_SCL(0)/pad_out | Pin_I2C_SCL(0)_PAD:out | 0.000
Clock | | | | | Clock path delay | 0.000
\I2CM_LCD:I2C_FF\/sda_out | Pin_I2C_SDA(0)_PAD:out | 23.225

Type | Location | Fanout | Instance/Net | Source | Dest | Delay (ns)
i2ccell | F(I2C,0) | 1 | \I2CM_LCD:I2C_FF\ | \I2CM_LCD:I2C_FF\/clock | \I2CM_LCD:I2C_FF\/sda_out | 1.000
Route | | 1 | \I2CM_LCD:sda_x_wire\ | \I2CM_LCD:I2C_FF\/sda_out | Pin_I2C_SDA(0)/pin_input | 7.605
iocell15 | P3[0] | 1 | Pin_I2C_SDA(0) | Pin_I2C_SDA(0)/pin_input | Pin_I2C_SDA(0)/pad_out | 14.620
Route | | 1 | Pin_I2C_SDA(0)_PAD | Pin_I2C_SDA(0)/pad_out | Pin_I2C_SDA(0)_PAD:out | 0.000
Clock | | | | | Clock path delay | 0.000
