ryood/I2S_FG/Case/I2S_FG_Case_pb-2.pdf

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

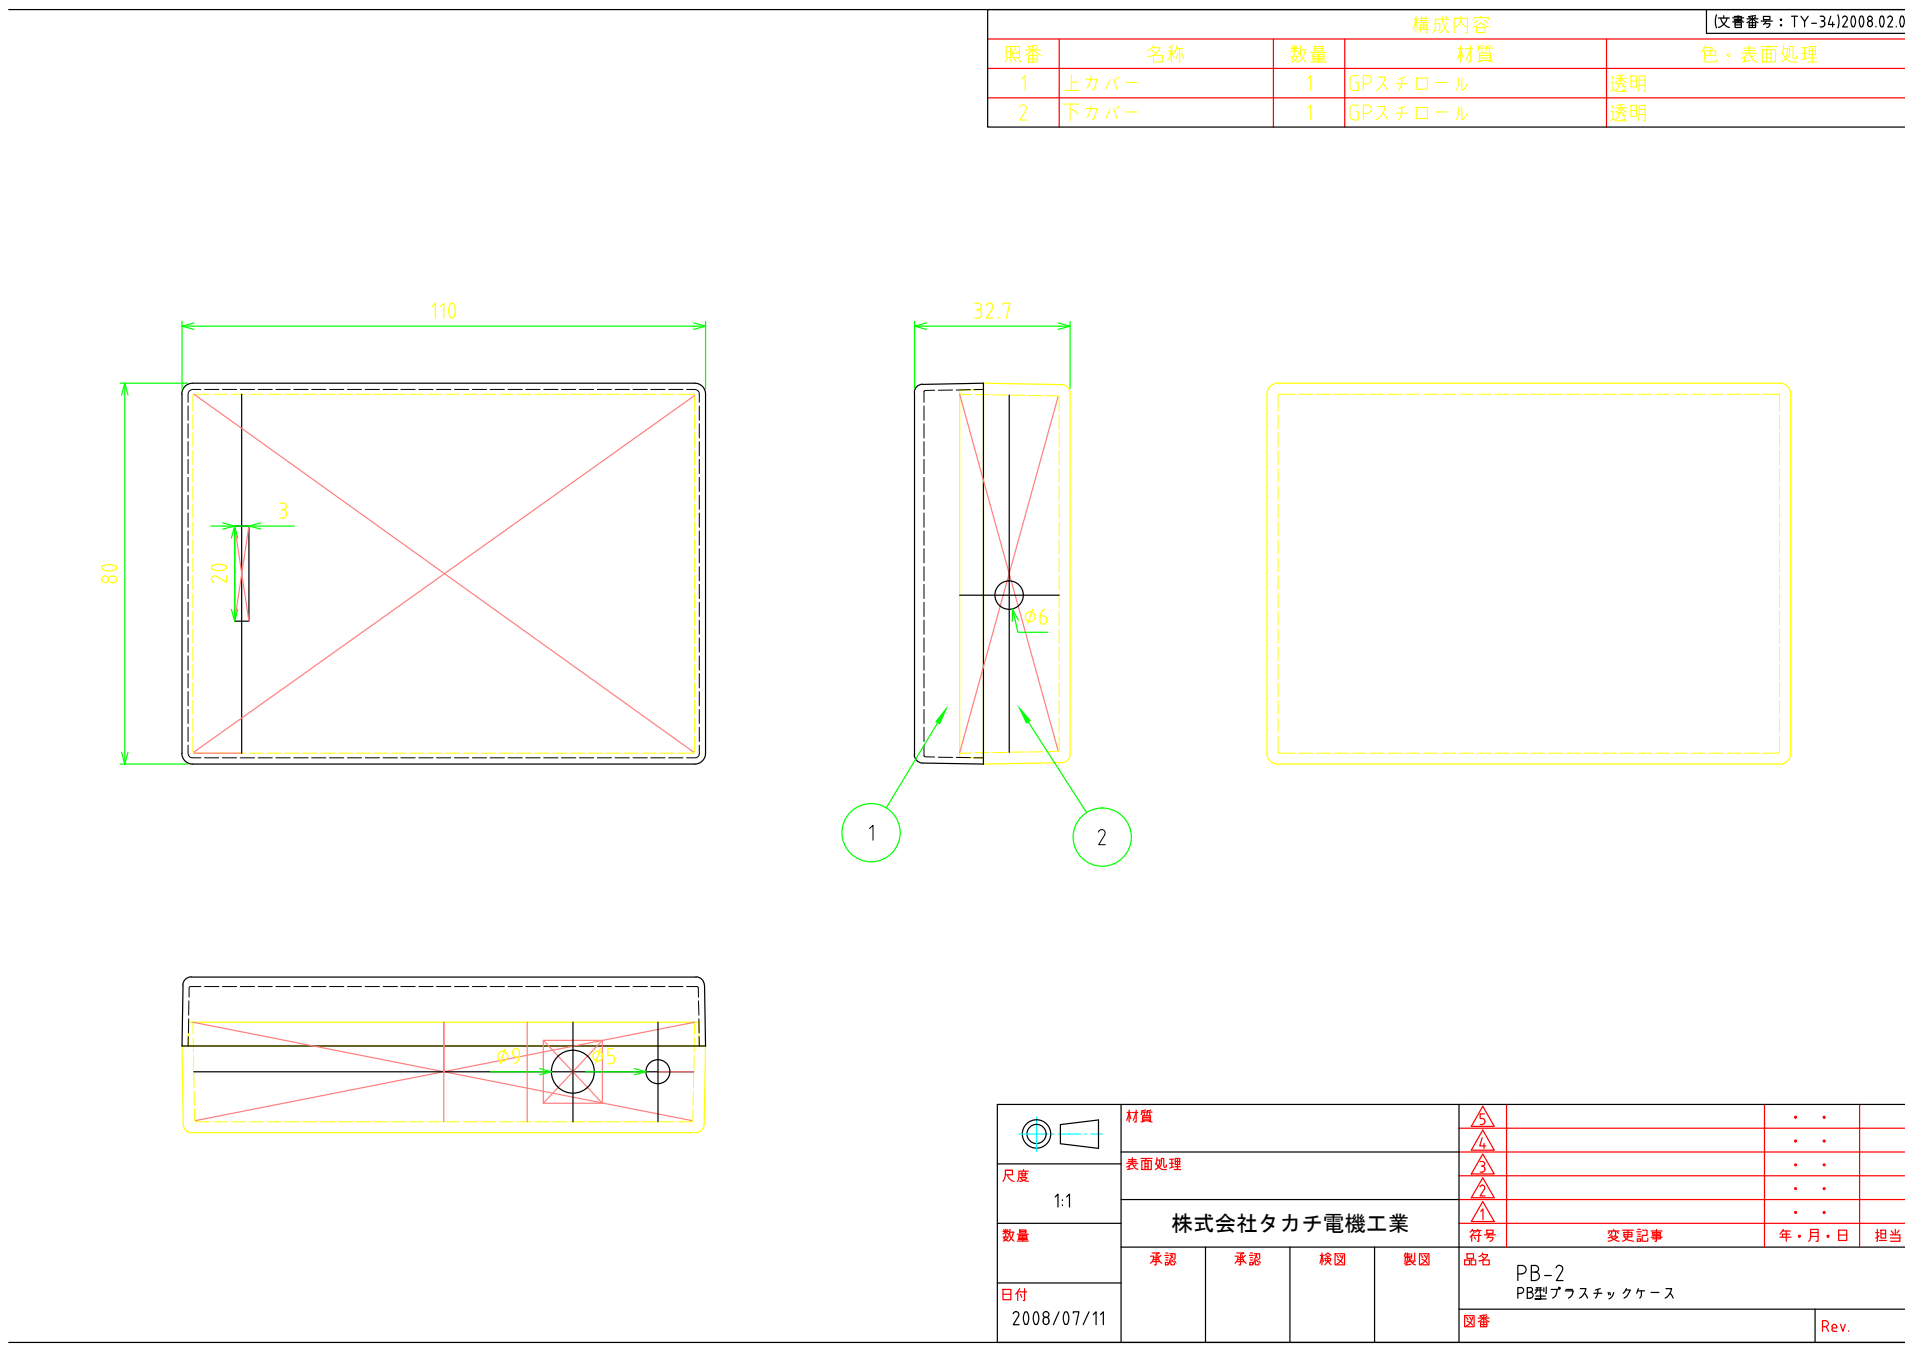
[picture p11: page 1]
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
