ryood/I2S_FG/LTSpice/LPF/2nd MFB with POT Buffer.asc

C1: cap; 540p
C2: cap; 100p
R1: res; 1.8k
R2: res; 6.8k
R3: res; 1.8k
R4: res; 1k
R5: res; {Ra}
R6: res; {10k-Ra}
U1: UniversalOpamp2
U2: UniversalOpamp2
V1: voltage; PULSE(-1 1 0 2.5u 2.5u 0 5u); AC 1
V2: voltage; 4.5V
V3: voltage; -4.5V
Named nets: 0, VCC, VEE, FOUT, NOUT
;tran 0 100u 50u
.ac oct 10 10 10Meg
.step param Ra list 10 1k 5k 9k 9.9k
