ryood/I2S_FG/LTSpice/LPF/2nd Multipule FeedBack.asc

C1: cap; 220pF
C2: cap; 68pF
R1: res; {Ra}
R2: res; 8.2k
R3: res; 4.7k
R4: res; 1k
U1: UniversalOpamp2
V1: voltage; PULSE(-1 1 0 2.5u 2.5u 0 5u); AC 1
V2: voltage; 2.5V
V3: voltage; -2.5V
Named nets: 0, VCC, VEE, OUT
.tran 0 100u 50u
;ac oct 10 10 10Meg
.step param Ra list 1k 5k 10k 20k
