ryood/I2S_FG/LTSpice/LPF/3rd MFB with POT Buffer.asc

C1: cap; 3300p
C2: cap; 1000p
C3: cap; 100p
R1: res; 150
R2: res; 820
R3: res; 2.2k
R4: res; 1k
R5: res; {10k-Ra}
R6: res; {Ra}
U1: UniversalOpamp2
U2: UniversalOpamp2
V1: voltage; PULSE(-1 1 0 2.5u 2.5u 0 5u); AC 1
V2: voltage; 2.5V
V3: voltage; -2.5V
Named nets: 0, OUT, VCC, VEE
;ac oct 10 10 100Meg
.tran 0 100u 50u
.step param Ra list 10 1k 5k 9k 9.9k
