ryood/I2S_FG/LTSpice/LPF/3rd MFB with POT.asc

C1: cap; 3300p
C2: cap; 1000p
C3: cap; 100p
R1: res; 150
R2: res; 820
R3: res; 2.2k
R4: res; 1k
U1: UniversalOpamp2
V1: voltage; PULSE(-1 1 0 2.5u 2.5u 0 5u); AC 1
Named nets: 0
.ac oct 10 10 100Meg
;tran 0 100u 50u
