ryood/I2S_FG/LTSpice/LPF/3rd Multipule FeedBack with POT.asc

C1: cap; 680p
C2: cap; 47p
C3: cap; 3.3p
R1: res; 1.3k
R2: res; 43k
R3: res; 100k
R4: res; 56k
R5: res; 1k
R6: res; {Ra}
R7: res; {10k-Ra}
U1: UniversalOpamp2
V1: voltage; PULSE(-1 1 0 2.5u 2.5u 0 5u); AC 1
V2: voltage; 2.5V
V3: voltage; -2.5V
Named nets: 0, OUT, VCC, VEE
;tran 0 100u 50u
.ac oct 10 100 1G
.step param Ra list 10 1k 5k 9k 9.9k
