ryood/I2S_FG/LTSpice/LPF/3rd VCVS with POT Buffer.asc

C1: cap; 100p
C2: cap; 100p
C3: cap; 470p
R1: res; 3.9k
R2: res; 1.2k
R3: res; 2.7k
R4: res; {Ra}
R5: res; {10k-Ra}
U1: UniversalOpamp2
U2: UniversalOpamp2
V1: voltage; 2.5V
V2: voltage; -2.5V
V3: voltage; PULSE(-1 1 0 2.5u 2.5u 0 5u); AC 1
Named nets: 0, VCC, VEE, OUT
;tran 0 100u 50u
.ac oct 10 10 100Meg
.step param Ra list 10 2.5k 5k 7.5k 9.9k
