ryood/I2S_FG/LTSpice/LPF/3rd VCVS with POT.asc

C1: cap; 68p
C2: cap; 33p
C3: cap; 4.7p
R1: res; 13k
R2: res; 120k
R3: res; 36k
R4: res; {Ra}
R5: res; {10k-Ra}
U1: UniversalOpamp2
V1: voltage; PULSE(-1 1 0 2.5u 2.5u 0 5u); AC 1
V2: voltage; 2.5V
V3: voltage; -2.5V
Named nets: 0, VCC, VEE, OUT
;tran 0 100u 50u
.ac oct 10 10 1G
.step param Ra list 10 1k 5k 9k 9.9k
