ryood/I2S_FG/LTSpice/LPF/SineWave.asc

V1: voltage; SINE(0 1 200k)
Named nets: 0, OUT
.tran 0 100u 50u
