ryood/I2S_FG/LTSpice/LPF/Triple CR with POT.asc

C1: cap; 1n
C2: cap; 1n
C3: cap; 1n
R1: res; 820
R2: res; 820
R3: res; 820
R4: res; {Ra}
R5: res; {10k-Ra}
U1: UniversalOpamp2
V1: voltage; PULSE(-1 1 0 2.5u 2.5u 0 5u); AC 1
V2: voltage; 2.5V
V3: voltage; -2.5V
Named nets: 0, OUT, VCC, VEE
.step param Ra list 10 1k 5k 9k 9.9k
.tran 0 100u 50u
;ac oct 10 10 1G
