ryood/I2S_FG/(list of files, drawings)

Other design files:
Fritzing/I2S_FG_UI+Power_Supply+PCM5102A+LCD_DirectDrive.fzz
Fritzing/I2S_FG_UI+Power_Supply+PCM5102A.fzz
Fritzing/I2S_FG_UI+Power_Supply.fzz
Fritzing/I2S_FG_UI.fzz
Fritzing/KitProg UART.fzz
Fritzing/PCM5102A-PSoC 5LP CQ PMB.fzz
Fritzing/PCM5102A-PSoC 5LP Prototyping Kit.fzz
Fritzing/PCM5102A.fzz
Fritzing/PCM5102a_FG_ケース内配線.fzz
