ryood/I2S_FG/Eagle/PCM5102a_FG/PCM5102a_FG_Small_1.brd

## EAGLE design Eagle/PCM5102a_FG/PCM5102a_FG_Small_1.brd (2016-03-01)

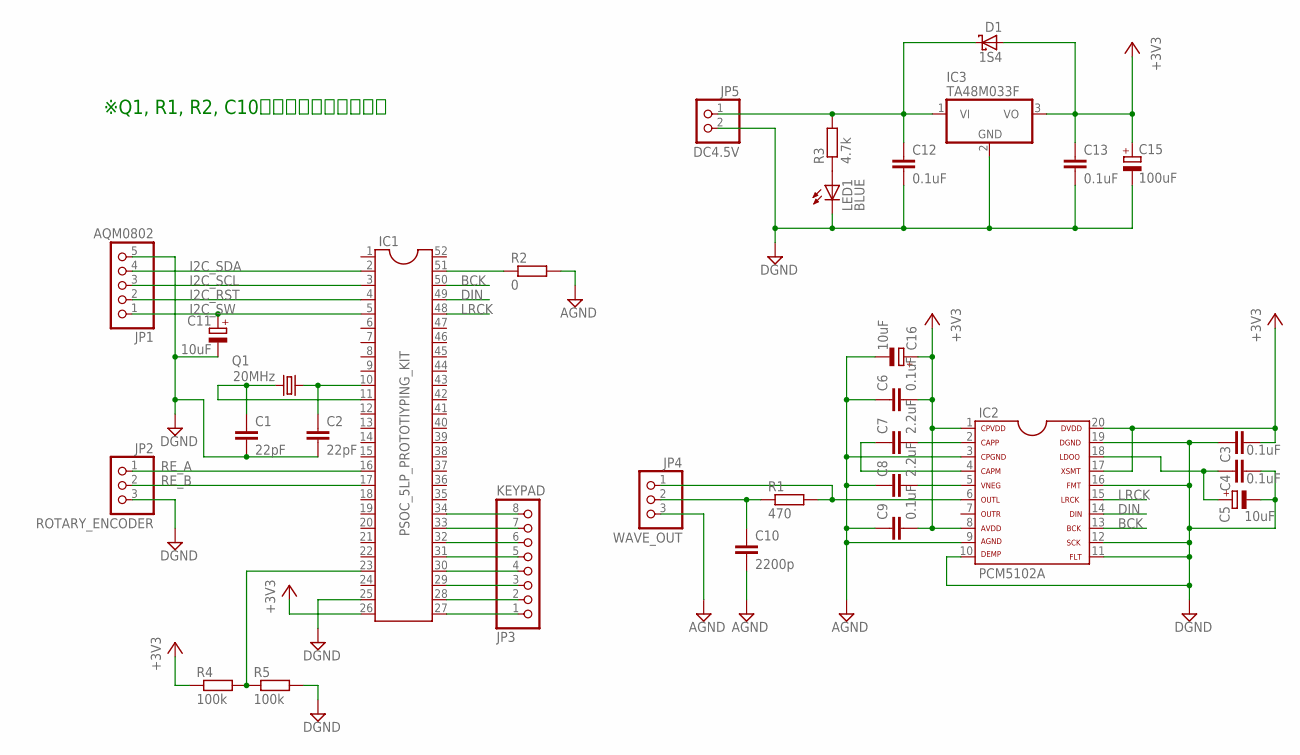
[picture p12: schematic PCM5102a_FG_Small_1.sch]

Parts:
C1, C2: 22pF; C050-024X044
C3, C4, C6, C9, C12, C13: 0.1uF; C025-024X044
C5, C11, C16: 10uF; E2,5-5
C7, C8: 2.2uF; C075-063X106
C10: 2200p; C050-035X075
C15: 100uF; E2,5-7
D1: 1S4; DO35-7
IC1: PSOC_5LP_PROTOTIYPING_KIT; DIL52-8
IC2: PCM5102A; DIL20-6
IC3: TA48M033F; TO220V
JP1: AQM0802; 1X05
JP2: ROTARY_ENCODER; 1X03
JP3: KEYPAD; 1X08
JP4: WAVE_OUT; 1X03
JP5: DC4.5V; 1X02
LED1: BLUE; LED3MM
Q1: 20MHz; HC49/S
R1: 470; 0207/7
R2: 0; 0207/7
R3: 4.7k; 0207/7
R4, R5: 100k; 0207/7

Connections:
+3V3: C3.2, C6.2, C9.2, C13.1, C15.+, C16.+, D1.A, IC1.26, IC2.1, IC2.8, IC2.17, IC2.20, IC3.3 (VO), R4.1
AGND: C6.1, C8.1, C9.1, C10.2, C16.-, IC2.3, IC2.9, JP4.3, R2.2
BCK: IC1.50, IC2.13
DC4.5V: C12.1, D1.C, IC3.1 (VI), JP5.1, R3.2
DGND: C1.2, C2.2, C3.1, C4.2, C5.-, C11.-, C12.2, C13.2, C15.-, IC1.25, IC2.10, IC2.11, IC2.12, IC2.16, IC2.19, IC3.2 (GND), JP1.5, JP2.3, JP5.2, LED1.K (C), R5.2
DIN: IC1.49, IC2.14
I2C_RST: IC1.4, JP1.2
I2C_SCL: IC1.3, JP1.3
I2C_SDA: IC1.2, JP1.4
I2C_SW: C11.+, IC1.5, JP1.1
LRCK: IC1.48, IC2.15
unnamed: C4.1, C5.+, IC2.18
unnamed: C7.2, IC2.2
unnamed: C7.1, IC2.4
unnamed: C8.2, IC2.5
unnamed: IC2.6, JP4.1, R1.2
unnamed: C10.1, JP4.2, R1.1
unnamed: IC1.27, JP3.1
unnamed: IC1.28, JP3.2
unnamed: IC1.29, JP3.3
unnamed: IC1.30, JP3.4
unnamed: IC1.31, JP3.5
unnamed: IC1.32, JP3.6
unnamed: IC1.33, JP3.7
unnamed: IC1.34, JP3.8
unnamed: C2.1, IC1.10, Q1.1
unnamed: C1.1, IC1.11, Q1.2
unnamed: IC1.51, R2.1
unnamed: IC1.23, R4.2, R5.1
unnamed: LED1.A, R3.1
RE_A: IC1.16, JP2.1
RE_B: IC1.17, JP2.2

Notes on the sheet:
※Q1, R1, R2, C10はピンソケットで実装

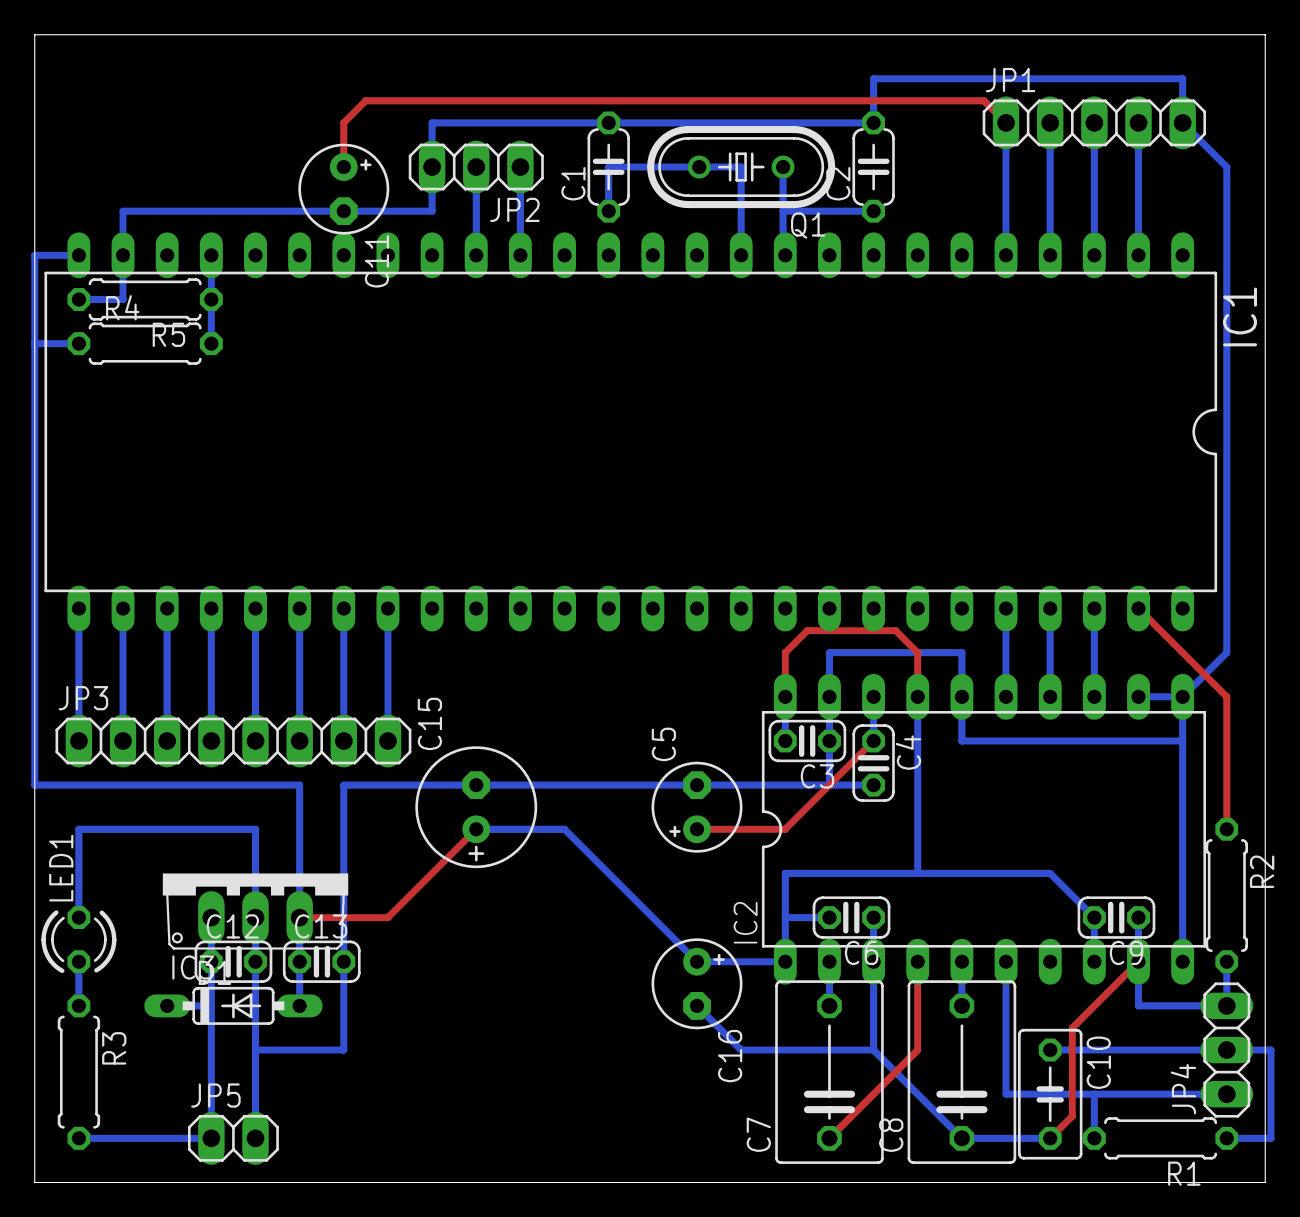
[picture p13: board PCM5102a_FG_Small_1.brd from above]

Board: 2 copper layers, 70.8 x 66.0 mm, 31 parts (0 on the bottom side), 32 nets.
