ryood/I2S_FG/PSoC/I2S_FG/PrototypingKit_FG.cydsn/wavetable32_0_9_8192.h

/*
 * 32bit singned int wave table (x0.9)
 * 8192 length
 */

#ifndef _WAVETABLE32_0_9_8192_H_
#define _WAVETABLE32_0_9_8192_H_

/*** sine wave (signed) 8192 ***/
const int32 sineTable[] = {    
	0	,
	1482389	,
	2964777	,
	4447164	,
	5929548	,
	7411928	,
	8894304	,
	10376675	,
	11859040	,
	13341398	,
	14823748	,
	16306089	,
	17788421	,
	19270742	,
	20753052	,
	22235350	,
	23717635	,
	25199905	,
	26682161	,
	28164401	,
	29646625	,
	31128831	,
	32611019	,
	34093187	,
	35575336	,
	37057463	,
	38539569	,
	40021652	,
	41503712	,
	42985747	,
	44467757	,
	45949741	,
	47431698	,
	48913627	,
	50395527	,
	51877397	,
	53359237	,
	54841045	,
	56322822	,
	57804565	,
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
};

/*** saw wave (signed) 8192 ***/
const int32 sawupTable[] = { 
	-1932735282	,
	-1932263422	,
	-1931791563	,
	-1931319704	,
	-1930847845	,
	-1930375986	,
	-1929904126	,
	-1929432267	,
	-1928960408	,
	-1928488549	,
	-1928016690	,
	-1927544830	,
	-1927072971	,
	-1926601112	,
	-1926129253	,
	-1925657394	,
	-1925185534	,
	-1924713675	,
	-1924241816	,
	-1923769957	,
	-1923298098	,
	-1922826238	,
	-1922354379	,
	-1921882520	,
	-1921410661	,
	-1920938802	,
	-1920466942	,
	-1919995083	,
	-1919523224	,
	-1919051365	,
	-1918579506	,
	-1918107646	,
	-1917635787	,
	-1917163928	,
	-1916692069	,
	-1916220210	,
	-1915748350	,
	-1915276491	,
	-1914804632	,
	-1914332773	,
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
};

#endif
/* [] END OF FILE */
