ryood/I2S_FG/PSoC/I2S_FG/PrototypingKit_FG.cydsn/wavetable32_0_9.h

/*
 * 32bit singned int wave table (x0.9)
 * 1024 length
 */

#ifndef _WAVETABLE32_0_9_H_
#define _WAVETABLE32_0_9_H_

/*** sine wave (signed) 1024 ***/
const int32 sineTable[] = {
	0	,
	11859040	,
	23717635	,
	35575336	,
	47431698	,
	59286274	,
	71138618	,
	82988284	,
	94834825	,
	106677796	,
	118516750	,
	130351242	,
	142180827	,
	154005059	,
	165823492	,
	177635682	,
	189441185	,
	201239555	,
	213030348	,
	224813121	,
	236587430	,
	248352832	,
	260108883	,
	271855141	,
	283591164	,
	295316510	,
	307030738	,
	318733406	,
	330424074	,
	342102301	,
	353767649	,
	365419677	,
	377057948	,
	388682023	,
	400291464	,
	411885834	,
	423464697	,
	435027616	,
	446574158	,
	458103885	,
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
};

#endif
/* [] END OF FILE */
