ryood/I2S_FG/PSoC/I2S_FG/PrototypingKit_FG.cydsn/wavetable32_0_9_2048.h

/*
 * 32bit singned int wave table (x0.9)
 * 2048 length
 */

#ifndef _WAVETABLE32_0_9_2048_H_
#define _WAVETABLE32_0_9_2048_H_

/*** sine wave (signed) 2048 ***/
const int32 sineTable[] = {       
	0	,
	5929548	,
	11859040	,
	17788421	,
	23717635	,
	29646625	,
	35575336	,
	41503712	,
	47431698	,
	53359237	,
	59286274	,
	65212753	,
	71138618	,
	77063813	,
	82988284	,
	88911973	,
	94834825	,
	100756784	,
	106677796	,
	112597803	,
	118516750	,
	124434582	,
	130351242	,
	136266676	,
	142180827	,
	148093640	,
	154005059	,
	159915028	,
	165823492	,
	171730396	,
	177635682	,
	183539297	,
	189441185	,
	195341289	,
	201239555	,
	207135926	,
	213030348	,
	218922765	,
	224813121	,
	230701362	,
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
};
    
#endif

/* [] END OF FILE */
