ryood/I2S_FG/PSoC/I2S_FG/PrototypingKit_FG.cydsn/wavetable32_0_9_32768.h

/*
 * 32bit singned int wave table (x0.9)
 * 32768 length
 */

#ifndef _WAVETABLE32_0_9_32768_H_
#define _WAVETABLE32_0_9_32768_H_
    
 /*** sine wave (signed) 32768 ***/
const int32 sineTable[] = {
	0	,
	370597	,
	741194	,
	1111791	,
	1482389	,
	1852986	,
	2223583	,
	2594180	,
	2964777	,
	3335374	,
	3705971	,
	4076567	,
	4447164	,
	4817760	,
	5188356	,
	5558952	,
	5929548	,
	6300143	,
	6670739	,
	7041334	,
	7411928	,
	7782523	,
	8153117	,
	8523711	,
	8894304	,
	9264898	,
	9635491	,
	10006083	,
	10376675	,
	10747267	,
	11117859	,
	11488450	,
	11859040	,
	12229630	,
	12600220	,
	12970809	,
	13341398	,
	13711986	,
	14082574	,
	14453161	,
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
};
   
#endif

/* [] END OF FILE */
