ryood/I2S_FG/PSoC/I2S_FG/PrototypingKit_FG.cydsn/wavetable16_0_9.h

/*
 * 16bit singned int wave table (x0.9)
 * 1024 length
 */
#ifndef _WAVETABLE16_0_9_H_
#define _WAVETABLE16_0_9_H_

/*** sine wave (signed) 1024 ***/
const int16 sineTable[] = {
	0	,
	180	,
	361	,
	542	,
	723	,
	904	,
	1085	,
	1266	,
	1447	,
	1627	,
	1808	,
	1988	,
	2169	,
	2349	,
	2530	,
	2710	,
	2890	,
	3070	,
	3250	,
	3430	,
	3609	,
	3789	,
	3968	,
	4148	,
	4327	,
	4505	,
	4684	,
	4863	,
	5041	,
	5219	,
	5397	,
	5575	,
	5753	,
	5930	,
	6107	,
	6284	,
	6461	,
	6637	,
	6813	,
	6989	,
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
};

#endif

/* [] END OF FILE */
