ryood/I2S_FG/(commit log)

2016-02-11 Add: Fritzing File
    [PCM5102A.fzz]
2016-02-11 正弦波形を0.9倍に
2016-02-11 32bitテーブル/32768要素数
2016-02-11 Lchのみ出力
2016-02-11 __REV()関数を使用
2016-02-14 UI_Test: Rotary Encoder
2016-02-14 Add: I2S_FG_UI Fritzing Files
    [I2S_FG_UI+Power_Supply.fzz, I2S_FG_UI.fzz, KitProg UART.fzz]
2016-02-18 UI_Test: 電卓のようにキーパッドから周波数値を入力
    [I2S_FG_UI+Power_Supply.fzz]
2016-02-19 Add: I2S_FG_UI+Power_Supply+PCM5102A.fzz
    [I2S_FG_UI+Power_Supply+PCM5102A.fzz]
2016-02-19 Add: PrototypingKit_FG_Test
    [I2S_FG_UI+Power_Supply.fzz]
2016-02-21 Add: I2C LCD Direct Dirve Fritzing file
    [I2S_FG_UI+Power_Supply+PCM5102A+LCD_DirectDrive.fzz]
2016-02-21 Add: Eagle File
    [PCM5102a_FG.brd, PCM5102a_FG.sch, PCM5102a_FG_Small.brd, PCM5102a_FG_Small.sch, PCM5102a_FG_Small_1.brd, PCM5102a_FG_Small_1.sch]
2016-02-21 Update: Eagle Files
    [PCM5102a_FG_Small_1.brd]
2016-02-24 電源電圧測定
    [I2S_FG_UI+Power_Supply+PCM5102A+LCD_DirectDrive.fzz, PCM5102a_FG_Small_1.brd, PCM5102a_FG_Small_1.sch]
2016-02-24 LCDのコントラスト調整
    [PCM5102a_FG_Small_1.brd, PCM5102a_FG_Small_1.sch]
2016-02-24 基板図修正: PCM5102a_FG_Small_1.sch/brd
    [I2S_FG_UI+Power_Supply+PCM5102A+LCD_DirectDrive.fzz, PCM5102a_FG_Small_1.brd, PCM5102a_FG_Small_1.sch]
2016-02-27 PCM5102a_FG_Small_1.sch/brd Add: SBD
    [PCM5102a_FG_Small_1.brd, PCM5102a_FG_Small_1.sch]
2016-02-27 PCM5102a_FG_Small_1.brd 修正
    [PCM5102a_FG_Small_1.brd]
2016-03-01 ハードウェア完成
    [I2S_FG_Case_pb-2.dwg, I2S_FG_テスト表20160227.xlsx, I2S_FG_状態遷移図_20160228.xlsx, PCM5102a_FG_Small_1.brd, PCM5102a_FG_Small_1.sch, PCM5102a_FG_ケース内配線.fzz]
2016-03-03 テスト表更新、状態遷移図修正
    [I2S_FG_テスト表20160227.xlsx, I2S_FG_テスト表20160228.xlsx, I2S_FG_状態遷移図.xlsx, I2S_FG_状態遷移図_20160228.xlsx]
2016-03-03 PrototypingKit_FG.cydsn: UIを整理
2016-03-03 PrototypingKit_FG: Rotary Encoderによる周波数値の増減(範囲制限にBugあり)
2016-03-03 PrototypingKit_FG: Rotary Encoderによる周波数値の増減(修正)
2016-03-20 画像更新
2016-03-26 Sampling Rate: 19200Hz 状態遷移図更新
    [I2S_FG_状態遷移図.xlsx]
2016-03-26 サンプリング周波数を382kHzに
2016-03-29 ノコギリ波の出力
2016-03-29 UI状態遷移図更新
    [I2S_FG_状態遷移図.xlsx]
2016-03-29 UIを修正
2016-07-22 設定値をEEPROMに保存
